GRiM-01/Robotic-Arm/EDPA T Thakurdin 22139454 INDIVIDUAL FINAL REPORT (1).pdf

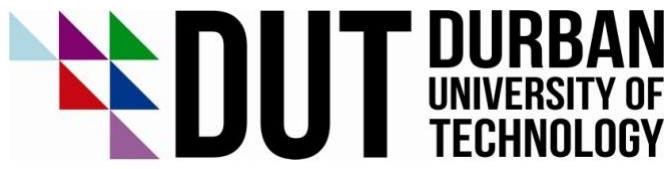
[picture p1: figure]

## Department of Electronic and Computer Engineering

## Electronic Design Project 3A (EDPA301)

## Assessment Number 5A

## Final Report (Individual)

## Project Title: Remote Controlled Robotic Arm that Measures Distance

By

## Group Number: A

Student Surname | Initials | Student Number
Thakurdin | T Y | 22139454

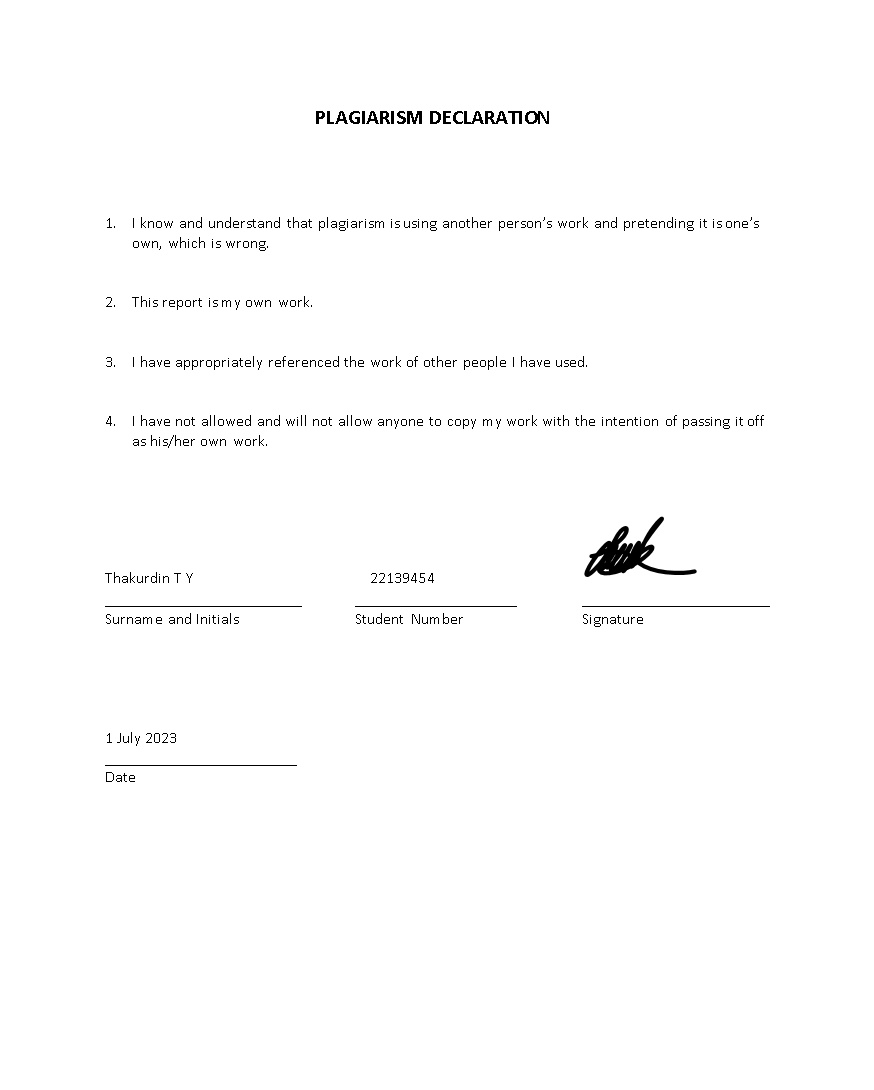
[picture p2: page 2]

ii

iii

### Abstract

This report discusses the design, construction, and testing of the remote-controlled robotic arm that

can measure distance project, specifically the joystick and servo motor subsystem.

The remote-controlled robotic arm was controlled by two joystick modules which were used to actuate

three servo motors which in turn enabled the movement of the robotic arm. The system incorporates

two ultrasonic distance sensors for vertical and horizontal distance measurements as well as two

nRF24L01+ modules to facilitate bi-directional wireless communication between the control centre

and the robotic arm microcontrollers. The final distance measurements were displayed on an I2C LCD

screen at the control centre. Indicator LEDs provided visual feedback for button presses and successful

data transfers.

Thus, this project offers a user-friendly and efficient solution for controlling and monitoring the robotic

arm’s functionalities by combining the joystick control of servo motors, ultrasonic sensors for distance

measurement, radio frequency modules for wireless communication, and an LCD screen and indicator

LEDs for real time process monitoring.

iv

### Table of Contents

PLAGIARISM DECLARATION | Error! Bookmark not defined.

v

vi

vii

### List of Figures

viii

### List of Tables

ix

### Table of Abbreviations

Abbreviations | Meaning
LED | Light Emitting Diode
LCD | Liquid Crystal Display
I2C | Inter-Integrated Circuit
Hz | Hertz
GND | Ground
VCC | Voltage Common Collector
RF | Radio Frequency
PS2 | PlayStation 2
DOF | Degrees of Freedom
I/O | Input and Output
ADC | Analogue to Digital Converter
DC | Direct Current

### Chapter 1: INTRODUCTION

### 1.1 Project Overview

A robotic arm is a machine that mimics the movement and motions of a human arm via the use of

linkages and joints which in turn enable the arm to manoeuvre within its defined degrees of freedom

and execute designated tasks [1-3].

Robotic arms are extensively used in medical surgeries, manufacturing, warehouses, assembly lines,

research laboratories and space exploration [4, 5]. They excel in challenging environments, offering

increased precision, repeatability, and efficiency.

In certain scenarios, remote control becomes necessary for robotic arms, particularly in military

applications like remote bomb defusal. This project aimed to undertake the research, design, and

construction of a remote-controlled robotic arm equipped with distance measurement capabilities

which holds potential real-world applications, such as assisting surgeons in intricate procedures where

precision cutting on a minute scale was required [4, 5].

This project utilized joysticks to control the precise actuation of servo motors to facilitate various

horizontal and vertical movements of the robotic arm and once held in a new position, distance

measurement commenced, and the results were displayed on an LCD.

The robotic arm consisted of interconnected joints, specifically the base, shoulder, and elbow joints,

each equipped with their individual servo motors used to facilitate the movement of the robotic arm.

User control was achieved at the control centre by utilizing two dual-axes joystick modules, the

physical X axis and Y axis movements of the joysticks served as analogue inputs for the control centre

microcontroller. This positional data was sent to the robotic arm system where they were converted

into PWM signals. These signals were used to control the rotation of the servo motors, enabling the

operator to manipulate the arm's movement and position.

To measure distance, ultrasonic sensors were implemented. These sensors emit sound waves, and the

distances were calculated based on the time it takes for sound waves to return.

For visual feedback, an LCD screen with an I2C interface was integrated into the system. The control

centre microcontroller was connected to the LCD display. The microcontroller received the transmitted

distance measurement data from the robotic arm system and displayed the final values on the LCD.

The two systems operated on separate DC power supplies which powered the microcontrollers which

in turn powered and controlled their respective components. This enables operators to remotely

control the robotic arm's movements using the joysticks while receiving real-time distance

measurement information on the LCD.

### 1.2 Aims, Objectives and Specifications

### 1.2.1 Aim

The aim of the project was to design, construct and test a remote-controlled robotic arm that was

capable of measuring distance. The project involved the development of two separate systems,

namely the control centre and robotic arm, each equipped with their own dedicated external DC

power supply.

### 1.2.2 Objectives

- Design and develop the control centre and robotic arm systems.
- Implement wireless communication between the control centre and the robotic arm using two

nRF24L01+ transceiver modules.

- Integrate an LCD into the control centre to display distance measurements from the robotic arm.
- Incorporate two PS2 joystick modules as the primary input devices for the control centre.
- Configure the robotic arm system to actuate three servo motors based on the input commands

received from the control centre.

- Utilize the Arduino microcontrollers to control and coordinate the functionalities of the control

centre and the robotic arm system.

- Establish bidirectional communication between the control centre and the robotic arm system to

enable the control centre to receive input commands from the joystick module and transmit them

wirelessly to the robotic arm system to actuate servo motors and transmit the calculated distance

measurements back to the control centre.

- Collaborate effectively with other group members to ensure a cohesive and coordinated project

outcome.

### 1.2.3 Hardware and Performance Specifications

- Arduino Uno Rev 3 microcontroller: The Arduino Uno Rev 3 microcontroller was used to control

the operations and functions of the control centre.

- Arduino ATmega328P microcontroller: The Arduino ATmega328P microcontroller was used to

control the operations and functions of the robotic arm system.

- Servo Motors: The project utilized three servo motors as the main output devices for controlling

the movements of the robotic arm.

- PS2 Dual-Axes joysticks: The joysticks served as the primary input devices for the control centre

and were used to control the movement of the robotic arm.

- I2C LCD: The final distance measurements were displayed at the control centre using the I2C LCD.
- NRF24L01+ transceiver modules: The NRF24L01+ transceiver modules facilitated wireless

communication between the control centre and the robotic arm.

- Accuracy: The robotic arm's movement and distance measurements must be accurate based on

the operator’s control.

- Responsiveness: The project must exhibit minimal delay and provide real-time response to

operator inputs.

- Reliability: The wireless communication between the control centre and the robotic arm must

maintain a consistent connection without significant signal loss.

- Reporting and Documentation: The project must be documented using IEEE referencing and

include technical specifications, wiring diagrams, code documentation, and project management

details.

### 1.2.4 Background and Significance

A robotic arm imitates human arm movements using linkages and joints. It operates within specific

degrees of freedom and performs various tasks in medical surgeries, manufacturing plants,

warehouses, assembly lines, research laboratories and space exploration [4, 5]. They are used in

challenging environments, offering precision, repeatability, and efficiency that a human could not.

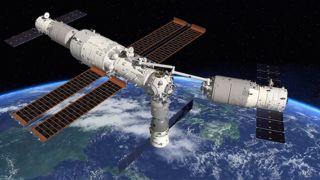
[picture p3: figure]

Figure 1.1 Robotic arm used to position a satellite [5].

A remote-controlled robotic arm with distance measurement capabilities offers valuable technical

benefits in various industries. It enhances operational safety by enabling operators to control the arm from a secure distance, ensuring precise object detection. Furthermore, the integration of the distance

measurement functionality ensures accurate and controlled movements, crucial for tasks that demand

precision [6].

By minimizing manual intervention, the remote-control feature streamlines operations, translating to

improved efficiency and safety [6]. Additionally, the arm's remote accessibility allows for exploration

and maintenance in challenging or remote environments.

### 1.2.5 Project Benefits

- Precise control over the movement and positioning of the robotic arm.
- Accurate distance measurement in two dimensions.
- Real time visual feedback of process operations due to indicator LEDs and LCD.
- Increased safety by performing tasks deemed too dangerous for humans.
- Increase efficiency due to

### 1.2.6 Project Limitations

- The servo motors have a limited rangeability between 0° - 180°.
- The robotic arm’s movement was limited to three DOF.
- The joysticks will degrade overtime and cause inaccuracies.
- The ultrasonic sensors have a limited measurement range from 2 – 19 cm.
- The transceiver module has a transmission rate limit of 250 Kbps to 2Mbps.
- The project faces power constraints due to the microcontrollers’ voltage limits.

### Chapter 2: DESIGN

### 2.1 Project Block Diagram

Figure 2.1 illustrates the systems block diagram. There are two main systems with three distinctstages.

The control centre system and robotic arm system each have an input stage, a process stage, and an

output stage.

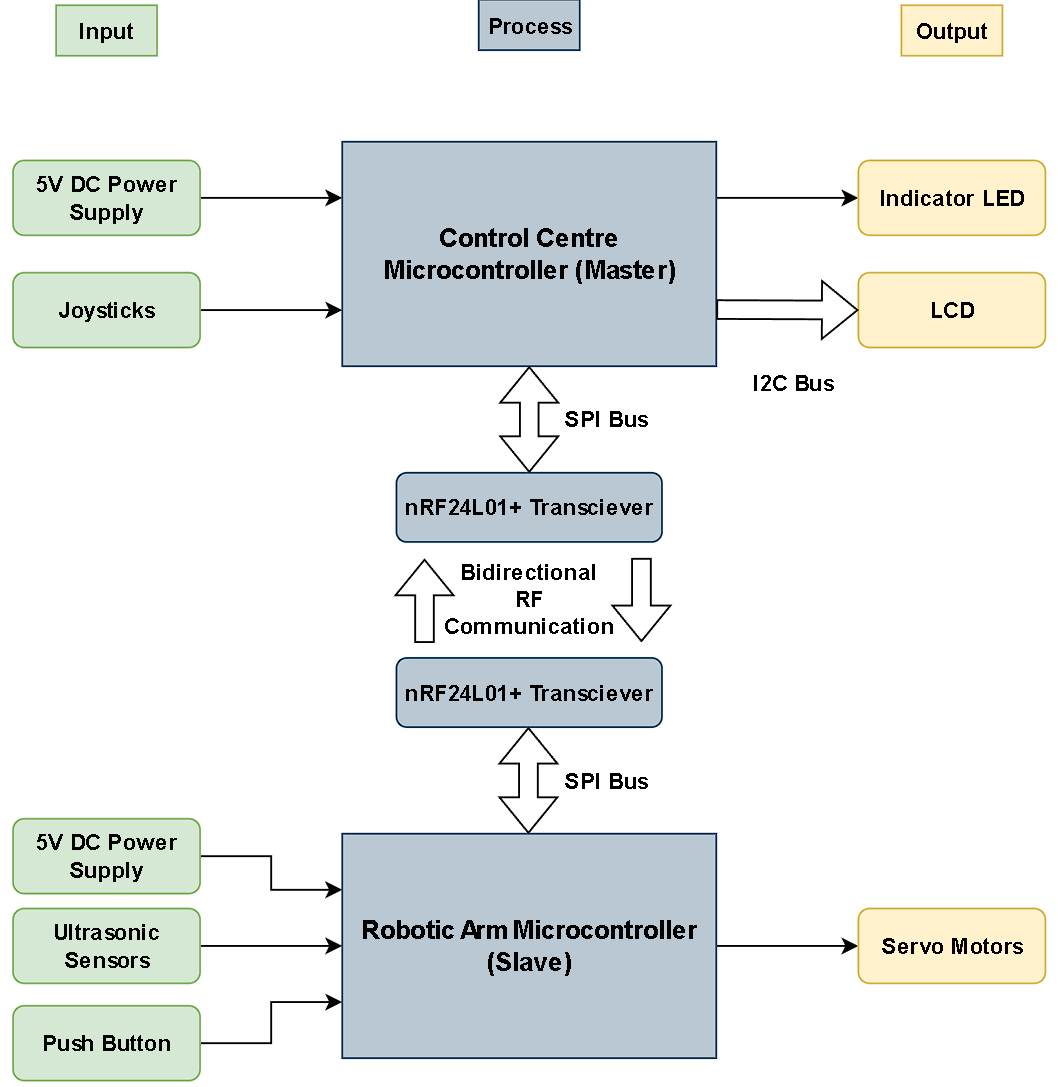
[picture p4: figure]

Figure 2. 1 Project Flowchart

### 2.1.1 Input Stage

With respect to the control centre’s input stage, the microcontroller was powered by a 5V DC power

source, which it used to distribute power to the other control centre components. Furthermore, the

microcontroller read the changing X-axis and Y-axis positions of the joystick as analogue inputs.

Within the input stage of the robotic arm system, the microcontroller was powered by a 5V DC power

source, which it used to distribute power to the other robotic arm system components. Such as the

ultrasonic sensors which functioned as the main input devices of this system furthermore, when the

push button was pressed once, the vertical distance was measured however if the button was pressed

twice, the horizontal distance was measured.

### 2.1.2 Process Stage

Within the process stage, the input data was converted and transmitted or received between the two

microcontrollers. The transmission of data was bidirectional and was facilitated using two nRF24L01+

transceiver modules.

The control centre stored the current position of the joystick and transmitted it to the robotic arm

microcontroller where it was then mapped to an angle between 0° and 180°. This angle was then used

to generate a PWM signal.

The robotic arm microcontroller converted the input from ultrasonic sensors into distance

measurements, in centimetres, which were transmitted to the control centre microcontroller.

### 2.1.3 Output Stage

The robotic arm microcontroller used the previously generated PWM signals to control the actuation

of the servo motors, in addition to this, the rotation of the servo motors caused the movement of the

robotic arm. By changing the position of the arm, various distance measurements could be taken.

The control centre microcontroller used the data which it received from the robotic arm system to

display the final distance measurement on the I2C LCD.

### 2.2 Project Circuit Diagram

As previously discussed, the project consists of two systems that communicate wirelessly., namely the

control centre system and robotic arm system which are shown in figures 2.2 and 2.3.

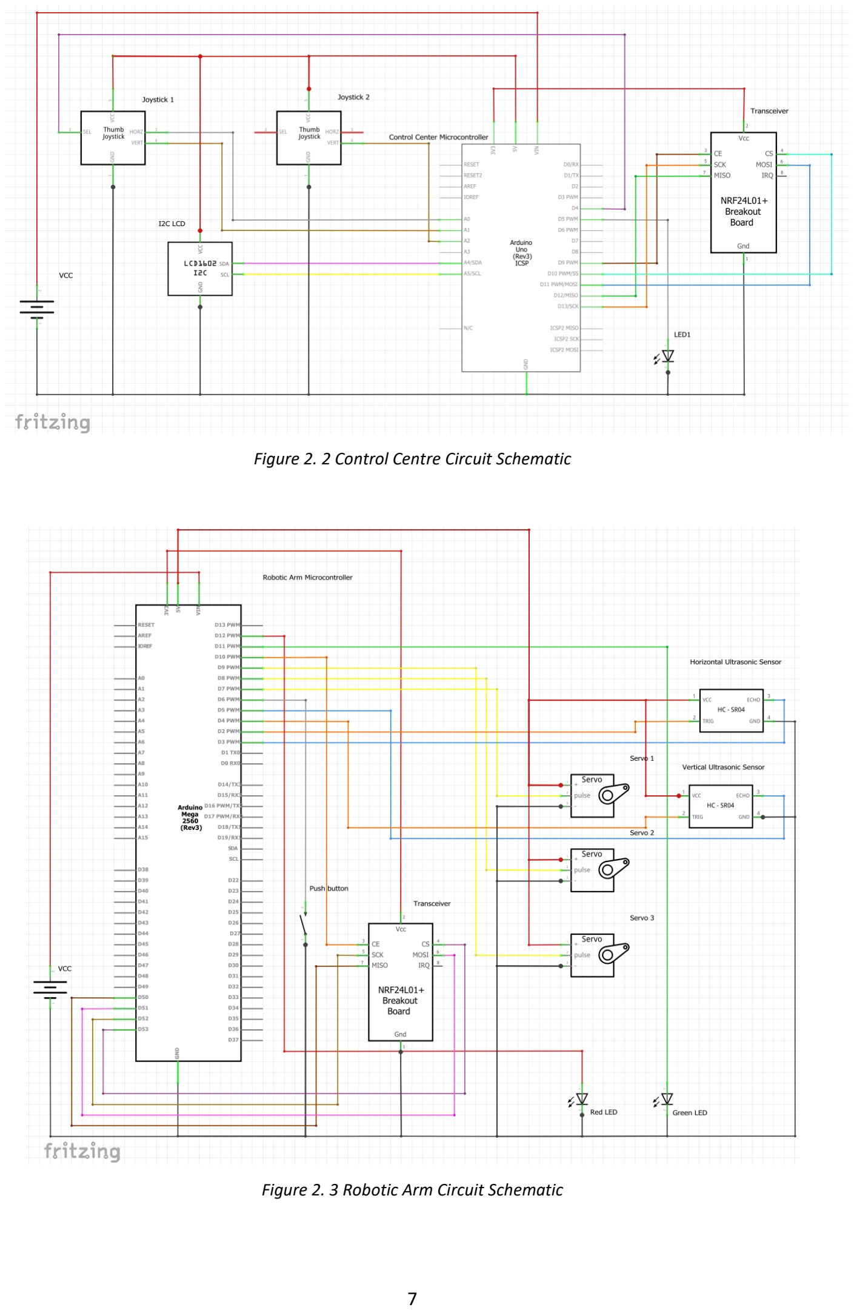
[picture p5: page 16]

Figure 2. 2 Control Centre Circuit Schematic

Figure 2. 3 Robotic Arm Circuit Schematic

### 2.2.1 Movement Stage:

The control centre system as the name suggests was where the operator remotely controlled the

project. This system contained the two dual axis joysticks which functioned as the main input devices

of the control centre that the operator interacted with to control the movement of the robotic arm.

This was accomplished by reading the changing X-axis and Y-axis positions of the joysticks as analogue

inputs. The joysticks were analogue inputs due to their ability to provide a continuous range of values,

which allowed for smooth and precise control over the arm’s movements, which was not achievable

with discrete on/off digital inputs [7, 8].

The joysticks’ positional data underwent serialization, where it was structured and formatted into a

data packet which was wirelessly transmitted to the robotic arm microcontroller using the radio

frequency transceiver modules.

The robotic arm microcontroller received the data packet and extracted the joystick positions. It then

mapped the positional data to an angle between 0° and 180° to make use of the servo motors’ full

range of motion. The mapped angle was used as an argument for the servo.write() function to

internally generate a PWM signal with the desired duty cycle and pulse width.

The PWM signal was generated on the digital I/O PWM pin connected to the signal wire of the servo

motor. The servo motor interpreted the pulse width of the signal, using its built-in control circuit, to

determine the desired degree of rotation, it then adjusted its shaft position based on the received

pulse width, aligning itself to the specified angle [9, 10]. The three servo motors, the base, shoulder,

and elbow servo motors were mounted on the robotic arm. The base servo motor facilitated horizontal

movement while the shoulder and elbow servo motors were responsible for vertical movement.

### 2.2.2 Distance measurements and display stage

To measure the distance covered by the robotic arm, the project included two HC-SR04 ultrasonic

sensors. These sensors emitted sound waves that travelled through the air and reflected off obstacles

encountered along the path.

For vertical distance measurement, the ground surface was detected as an obstacle, while a solid box

served as an obstacle for horizontal distance measurement. By calculating the time duration of the

echo pin's high state and utilizing the speed of sound, the distance could be accurately By using

formula 2-1 where D is the distance measured in cm, t is the time duration of the echo pin's high state,

0.34 is a constant representing the speed ofsound in air which is 0.034cm/µs and the division constant

2 represent the path of the sound wave being emitted to an obstacle its path back.

### D(cm) =

t∗0.34
2

[2-1]

This distance measurement was transmitted to the control centre microcontroller where it was

displayed on a 16×2 LCD which was interfaced with the control centre microcontroller through the I2C

interface.

### 2.2.3 Wireless communications stage

Two nRF24L01+ transceiver modules facilitated the wireless communications between the control

centre and robotic arms systems using radio frequency signals furthermore, the two systems

communicate bidirectionally.

Prior to the transmission stage, the input data was obtained and converted into a data packet. By

checking if the transmission channel was open, the microcontroller determined whether it should

transmit or receive data. If the transmission channel was available, the microcontroller transmitted

the data packet to the other system. Similarly, if the transmission channel was not available, the

microcontroller received the transmitted data packet and extracted the data from the other system.

This process was identical for both the systems. Should neither system have transmitted nor received

data, this would have indicated that either one or both systems were inoperative.

### 2.3 Factors Influencing Component Selection

### 2.3.1 Servo Motors

Precise positional control: Servo motors have built-in feedback mechanisms and control circuits

enabling accurate control of the motor's position. This precision is crucial for robotic arms, which

require precise and repeatable movements.

Compact size: Servo motors are available in compact sizes, making them suitable for robotic arm

designs where space is limited. They were easily integrated into the arm structure without adding

excessive bulk.

Ease of use and compatibility: Servo motors are easy to use and interface with and control due to the

Arduino h.Servo library which simplified their integration and programming.

Cost-effectiveness: Servo motors provided a good balance between performance and cost. They are

more affordable than other high-performance motor options, such as stepper motors or linear

actuators, while still offering the necessary capabilities for robotic arm applications.

### 2.3.2 Joysticks

Intuitive and ergonomic control: joysticks are designed with ergonomics in mind, providing a

comfortable grip and intuitive hand placement. This ensures that users can control the robotic arm

with ease and minimal fatigue over extended periods.

Two-dimensional control: Dual-axis joysticks provide control in two dimensions. This enabled precise

control over the horizontal and vertical movement of the robotic arm.

Simultaneous control: Dual-axis joysticks allow for simultaneous control of both axes.

Compact and lightweight: Dual-axis joysticks are compact and lightweight allowing them to be easily

integrated into the handheld control centre device.

Analogue input: Joysticks were used to provide a continuous range of values, which allowed for smooth

and precise control over movements, which is not achievable with discrete inputs such as a keypad.

Real-time control: Dual-axis joysticks provided real-time control, allowing users to make immediate

adjustments to the arm's position and movement.

### 2.3.3 Ultrasonic Sensors

Non-contact sensing: Ultrasonic sensors operate on a non-contact principle, meaning they do not

require physical contact with objects to measure distance. This feature was advantageous for the

robotic arm as it allows for safe and efficient object detection without the risk of collision or damage.

Fast response time: Ultrasonic sensors provide fast response times due to operating at the speed of

sound.

Cost-effective: Ultrasonic sensors are cost-effective compared to other sensing technologies like lidar

and vision systems. It offered a good balance between performance and cost.

### 2.3.4 nRF24L01+ Transceivers

Wireless communication: The transceivers provide wireless communication capabilities through radio

frequencies; wireless communications was one of the objectives of this project.

Reliable and robust connectivity: The transceivers offered dependable and connectivity, ensuring

stable and consistent communication between the robotic arm and control system.

Low power consumption: The transceivers are designed with low power consumption in mind. The

low power consumption of the transceivers helps prolong the battery life of the robotic arm.

Long-range communication: The transceivers can provide long-range communication capabilities,

allowing robotic arms to be controlled or monitored from a considerable distance.

Cost-effective: The transceivers provide a cost-effective solution for wireless communication and

offered a good balance between performance and cost.

### 2.3.5 I2C LCD

Simplified wiring: I2C LCD modules utilize the I2C protocol for communication. Compared to traditional

parallel LCDs, I2C LCD modules require fewer wires for connection.

Cost-effective: I2C LCD modules are cost-effective compared to other display technologies, such as

graphical LCDs or OLED displays. It provided a good balance between functionality and cost.

### 2.4 Software Design Method:

The following paragraphs explain the method and process of designing and implementing the code

and algorithms used for this project.

### 2.4.1 Requirements Analysis

The basic functionality and capabilities of the project were determined such as the range of motion,

number of degrees of freedom, and specific tasks the project had to perform such as distance

measurement and displaying the result.

### 2.4.2 System Architecture

The major components of the project were identified, such as the servo motors, joysticks, ultrasonic

sensors, transceiver modules and LCD. Flowcharts were then developed to visualize how these

components would work together to achieve the desired movements and functionality.

### 2.4.3 Algorithm Design

Algorithms for each subsystem were developed such as the joystick and servo motor control algorithm.

### 2.4.4 Code Organization

The individual algorithms were combined and organized into logical sections based on the different

components and systems to simplify troubleshooting and subsystem integration.

### 2.4.5 Component and sensor Integration

The final project was constructed, and the code was uploaded to assess if the project functioned and

met the specified objectives.

### 2.4.6 Testing and Iteration

The project was evaluated to ensure that the arm moved correctly and performed the desired tasks.

The code was enhanced through an iterative method to refine and functionality and address issues.

### 2.5 Software Resources

### 2.5.1 Fritzing

The Fritzing software was used to design and draw out the circuit diagrams.

### 2.5.2 Arduino IDE

This software was used to develop, run, and upload the code to the microcontrollers to translate the

change in position of the joystick into the actuation of the servo motors.

### 2.5.3 Diagrams.net

This software was utilized to design the system block diagram and flowchart for the servo motor and

joystick subsystem.

### 2.5.4 Tinkercad

This software was used to evaluate and visualize the range of motion of the servo motors through a

sweeping program.

### Chapter 3: CONSTRUCTION

### 3.1 Preliminary information on joystick and servo motor construction

The joysticks and servo motors were included in the 4DOF robotic arm kit and were interfaced with

their respective microcontrollers according to the circuit diagrams and the wiring configurations tables

3.2 and 3.3.

### 3.1.1 Joystick Specifications

The following are the joystick specifications from the manufacturer [7]:

- Dual-Axis, X and Y axis.
- Dimensions: 4 X 2.6 X 3.2cm.
- Two potentiometers for two axes.
- Connector Pins: +5Vcc, GND, VRx, VRy, SW.

The joysticks position was based on values between 0 and 1023 for both the X and Y axis, this is clearly

depicted in figure 3.1.

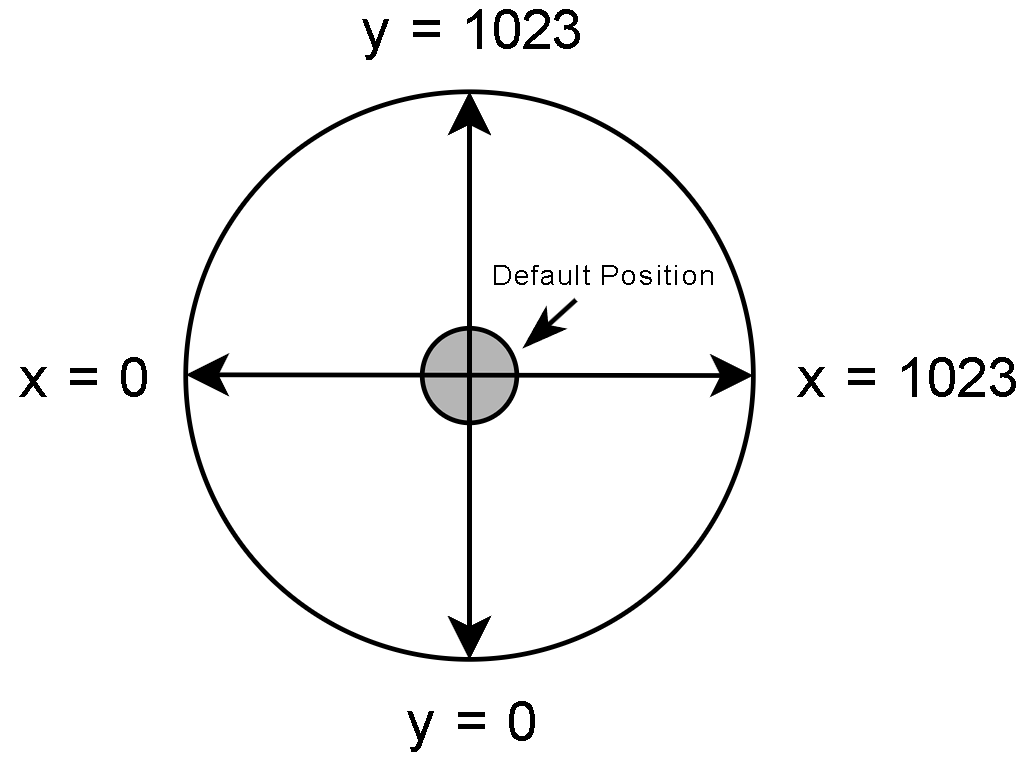
[picture p6: figure]

Figure 3. 1 Joystick Position Detection

The joystick values were represented as numbers from 0 to 1023 because they are measured using the

Arduino Uno’s 10-bit ADC [8]. This means the joystick's position was divided into 1024 steps, starting

from 0. The minimum position was represented by 0, and the maximum position was represented by

1023. These values were used to accurately track the joysticks’ movement.

### 3.1.2 Servo Motor

As shown in figure 3.2, the servomotors consist of a regular DC motor which was controlled by a built-

in control circuit [9]. The servo’s torque and speed are set by the gears and lastly the position

potentiometer provides feedback on the angle of rotation of the servo motor [9, 10].

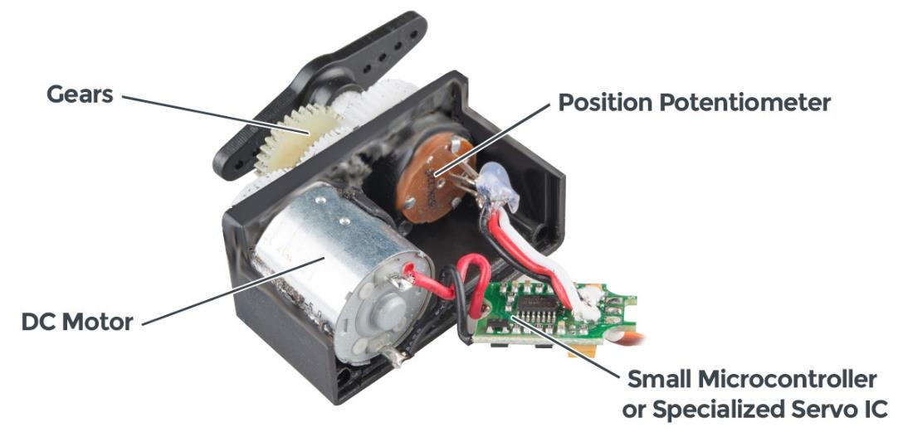
[picture p7: figure]

Figure 3. 2 Servo Motor Deconstructed [9]

The microcontroller maps the position of the joystick to an angle between 0° and 180°. This angle was

then used to generate a PWM signal which dictated the angle of rotation of the servo motor [9, 10].

The following are servo motor specifications from the manufacturer [11]:

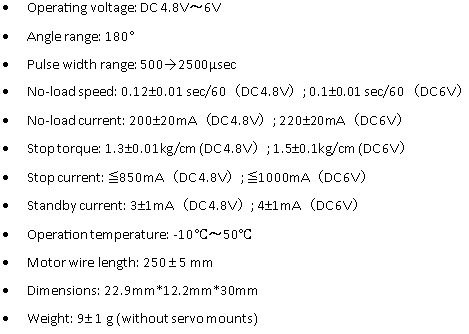
[picture p8: figure]

### 3.2 Individual role and tasks in construction

The role of the electromechanical servo motor engineer for this project required interfacing the servo

motors and joysticks with their respective microcontrollers as well, adjusting the screw tensions to

ensure the robotic arm moved smoothly and to ensure that the housings did not disrupt the

movement of the joysticks or servo motors.

Furthermore, a prototype for the joystick and servo motor subsystem was developed where the servo

motors and joysticks were connected to a single microcontroller to assess the functionality and

interactions as show in figure 3.3.

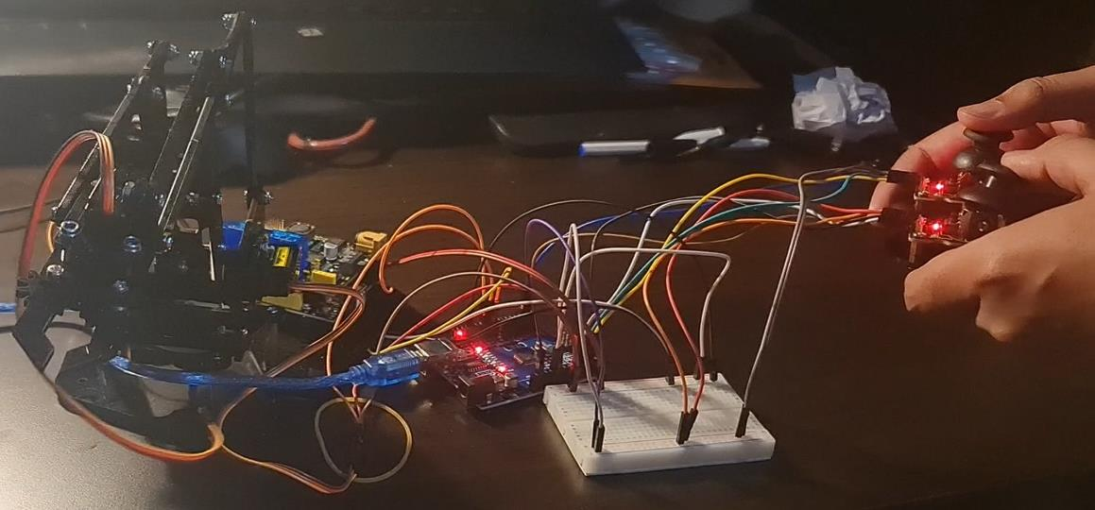
[picture p9: figure]

Figure 3. 3 Constructed Prototype for Servo Motor and Joystick Subsystem

### 3.3 Construction Overview

Preliminary circuit designs for subsystems and prototype were created using the Fritzing software.

Group members constructed subsystems according to their designated rolesto ensure proper working

of the components, demonstrate an understanding of their assigned tasks and limit errors incurred by

the final project artefact.

Following the successful testing of each subsystem, a prototype was constructed by combining the

individual subsystems into either the control centre system or the robotic arm system.

The construction process involved assembling the robotic arm structure according to the manual

provided with the 4DOF Robotic Arm kit as well as interfacing the electronic and mechanical

components together and lastly uploading the codes in annexures C and D which were developed

using the flowcharts in annexures E and F.

Furthermore, the servo motors were mounted onto the robotic arm structure and functioned asjoints.

The base servo motor rotated the base of the robotic arm allowing for horizontal movement while the

shoulder and elbow servo motors raised and lowered the arm’s linkages allowing for vertical

movement.

The vertical distance measuring ultrasonic sensor was mounted on the robotic arm structure in place

of the claw, while the horizontal distance measuring sensor was mounted at the base on the robotic

arm.

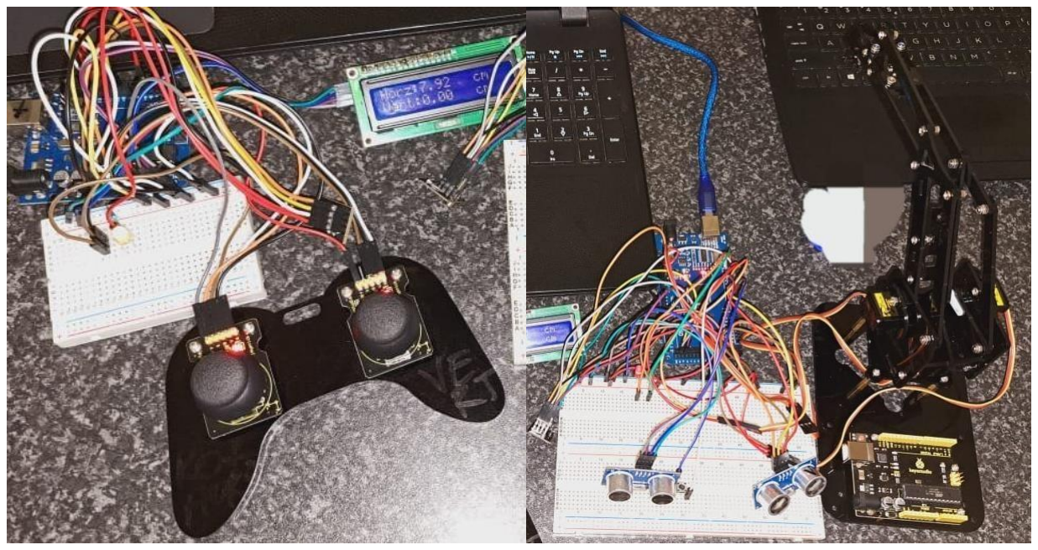
[picture p10: figure]

Figure 3. 4 Constructed Prototype for Control Centre and Robotic Arm

The project was assembled according to the designed circuit schematics and the wiring configurations

in tables 3.1 to 3.3.

Table 3. 1 Transceiver Module Pinout

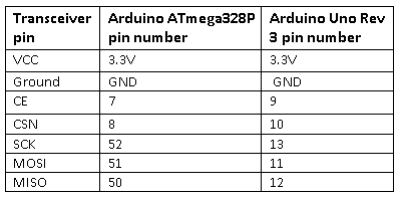
[picture p11: figure]
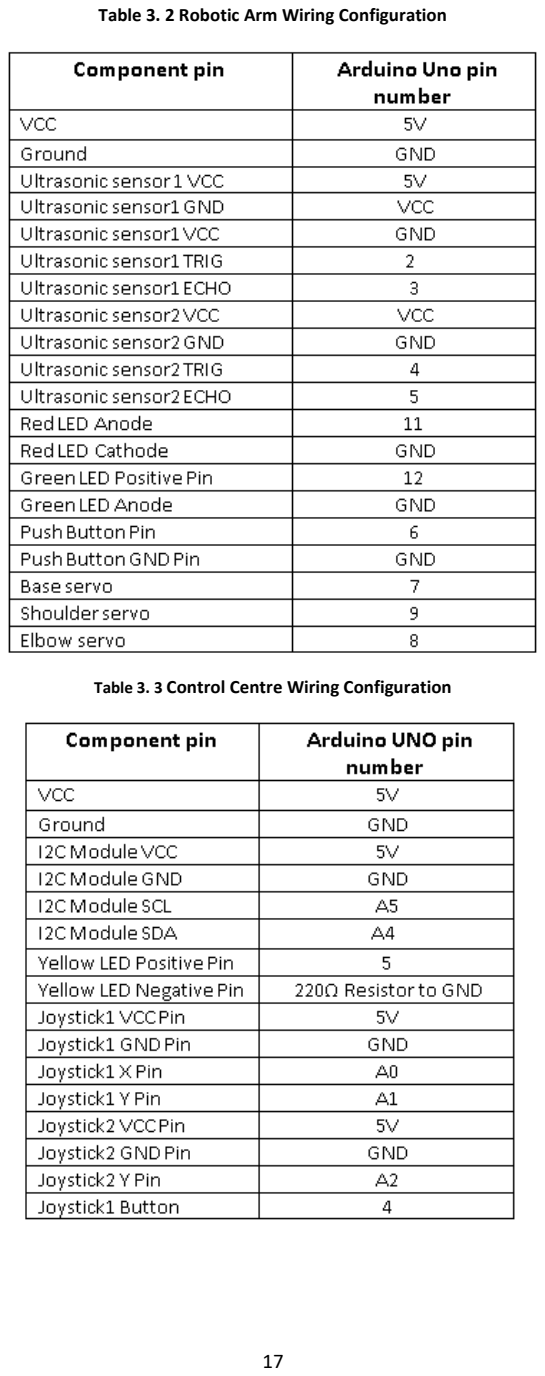
[picture p12: page 26]

Table 3. 2 Robotic Arm Wiring Configuration

Table 3. 3 Control Centre Wiring Configuration

Lastly, housing for both the robotic arm and control centre system were constructed to provide a layer

of protection to the components. Lastly through an iterative method, the prototype was refined into

the final artefact as can be seen in figure 3.5.

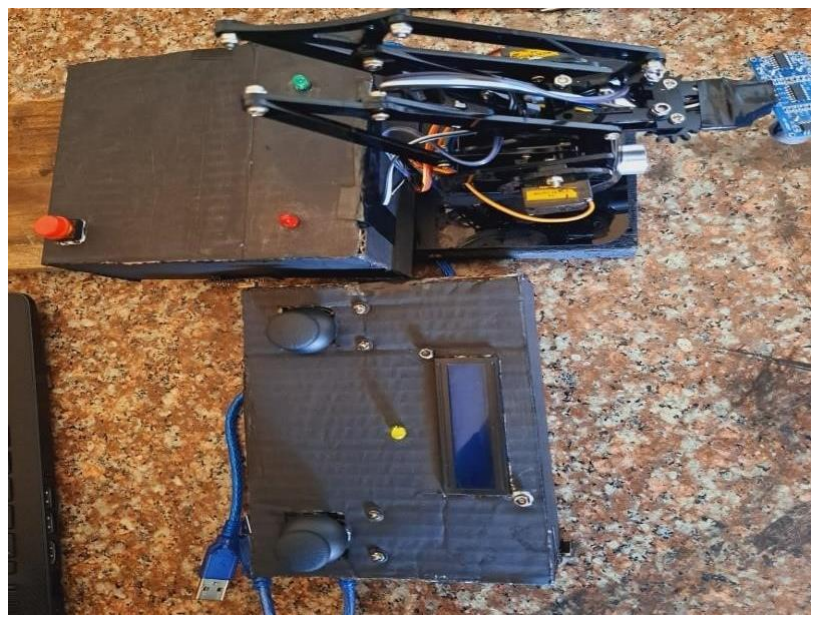
[picture p13: figure]

Figure 3. 5 Constructed Final Prototype for Control Centre and Robotic Arm

### Chapter 4: TESTING

### 4.1 Servo Motor Range of Motion Testing

The code used in annexure A was used to assess the full range of motion of the servo motors using a

sweep function that would increment and change the angle of the servo motor incrementally.

Subsequently, the serial monitor and plotter in figure 4.1 depict the results of this test. As can be seen,

the servo motor rotated from 0° to 180° and then from 180° to 0° repeatedly.

The sawtooth waveform occurs due to the delay where the servo motor stops for fifteen microseconds

and then flips the direction it rotates in, the serial plotter registered this as the servo motor starting at

180° again.

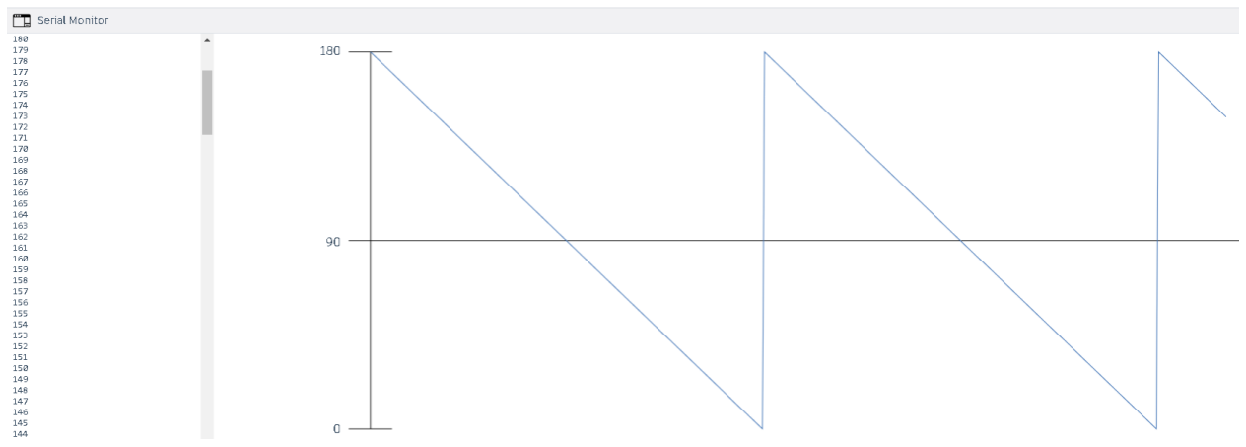
[picture p14: figure]

Figure 4. 1 Serial Monitor and Plotter for Servo Sweep Code

Furthermore, the codes in annexure I and J were used to calibrate the servo motors minimum and

maximum angles.

### 4.2 Subsystem Movement testing

An initial prototype circuit was constructed as shown in figures 4.2 and 4.3. The circuit consisted of the

robotic arm, servo motors, joysticks, and a single microcontroller. This test circuit was built to isolate

the servo motors and joysticks from the other subsystems within this project. This was done to

evaluate the aforementioned components and ensure that this subsystem was operational to lower

the risk of causing or incurring errors when the final project was constructed. Furthermore, each group

member performed a similar task with their respective subsystems where applicable.

Annexures G and K depict the subsystem flowchart and code, respectively. The code functions by

reading the changing position of the joystick as an analogue input and converting it to a PWM signal

used to control the rotation of the servo motors. By pressing the left joystick button, the servo motors enter hold mode where the position of the robotic arm does not change regardless of joystick input.

To exit hold mode, the joystick button simply had to be pressed again.

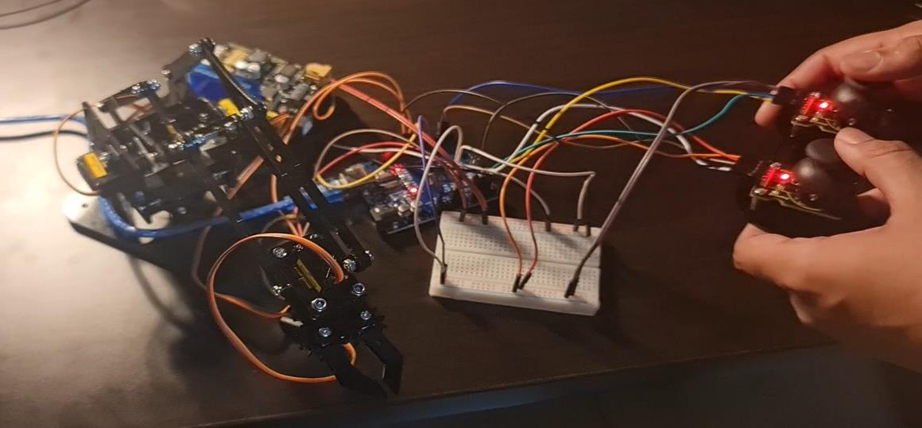
[picture p15: figure]

Figure 4. 2 Servo Motor and Joystick Subsystem Prototype

### 4.3 Project Testing

Once all the subsystems were interfaced the projects control centre and robotic arm systems were

powered on. The joysticks were used to control the movement of the robotic arm. Once the arm was

in the desired position, a push button was pressed once to read the vertical distance measurements

using the ultrasonic sensor 1 and when pushed twice ultrasonic sensor 2 was used to take the

horizontal distance measurements.

For vertical distance measurements, the arm’s vertical position was changed relative to the surface the

robotic arm rested on as this surface was the obstacle that ultrasonic sensor 1 detected. However, for

the horizontal distance measurement, an obstacle was introduced for ultrasonic sensor 2 to measure

the distance. The arm would move into the desired position and the relevant distance measurements

were taken as shown in figures 4.4 and 4.5.

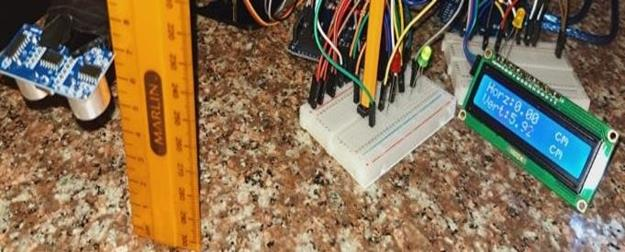
[picture p16: figure]

Figure 4. 3 Vertical Distance Measurement Test

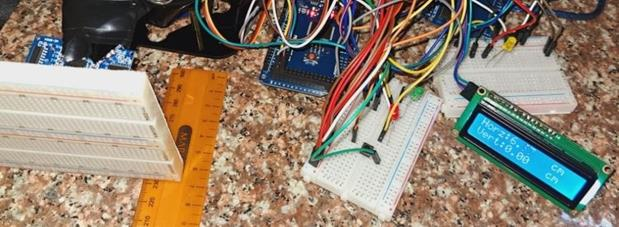
[picture p17: figure]

Figure 4. 4 Horizontal Distance Measurement Test

To verify the systems were functional, the LCD was used to display the distance measurements and

LED indicators depicted when a distance measurement was being done as well as when successful

data transfers had occurred between the control centre and the robotic arm systems.

### Chapter 5: RESULTS

### 5.1 Servo Motor and Joystick results

The servo motors actuated the joysticks precisely and accurately as intended. Figure 5.1 depicts the

serial monitor used to capture the changing position of the joysticks. The X and Y values correspond

to the joystick position as depicted in figure 3.1.

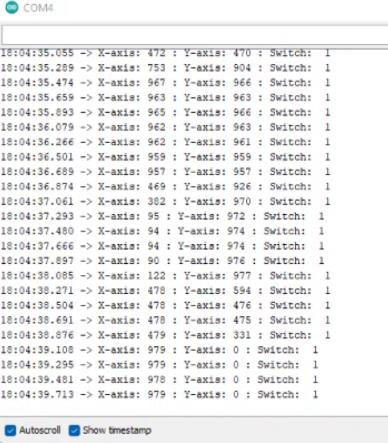
[picture p18: figure]

Figure 5. 1 Joystick Position Results

These values were mapped to an angle between 0° and 180° to actuate the servo motors. This angle

was used to generate a PWM signal to actuate the servo motors to the desired angles. Figure 3.2

depicts the relationship between angle of the servo motor’s rotation and the pulse width of the signal

sent to the servo motor.

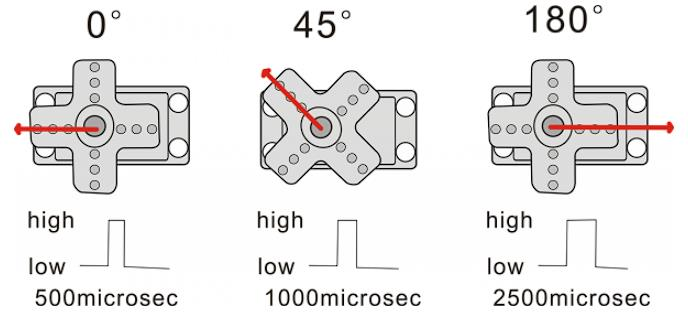
[picture p19: figure]

Figure 5. 2 Relationship Between Pulse Width and Servo Rotation [11]

### 5.2 Project Results

The measurement results obtained were accurate as expected however, there were discrepancies

caused by servo jitter, which are erratic movements of the servo motors caused by their high operating

speeds. Insufficient screw tension also inhibited the desired motion of the robotic arm however once

these issues were addressed, the robotic arm’s movement was smoother and more controlled.

Further discrepancies were caused by the ultrasonic sensor not being perfectly parallel to the

measured object as well as possible electrical noise as well as radio frequency interference from the

transceiver modules.

Table 5.1 shows the largest and the least variations that were measured during the testing phase.

Furthermore, equation 5-1 explains how the percentage error was calculated.

%E =

Ultrasonic Sensor Distance−Ruler Distance Ultrasonic Sensor Distance

× 100% | [5-1]

Table 5. 1 Final Project Distance Measurement Results

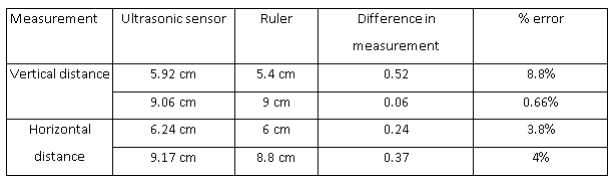
[picture p20: figure]

Figures 5.3 and 5.4 show the testing procedure for horizontal and vertical distance measurement, respectively. The green LED indicates horizontal distance measurement mode while the red LED indicates vertical distance measurement mode.

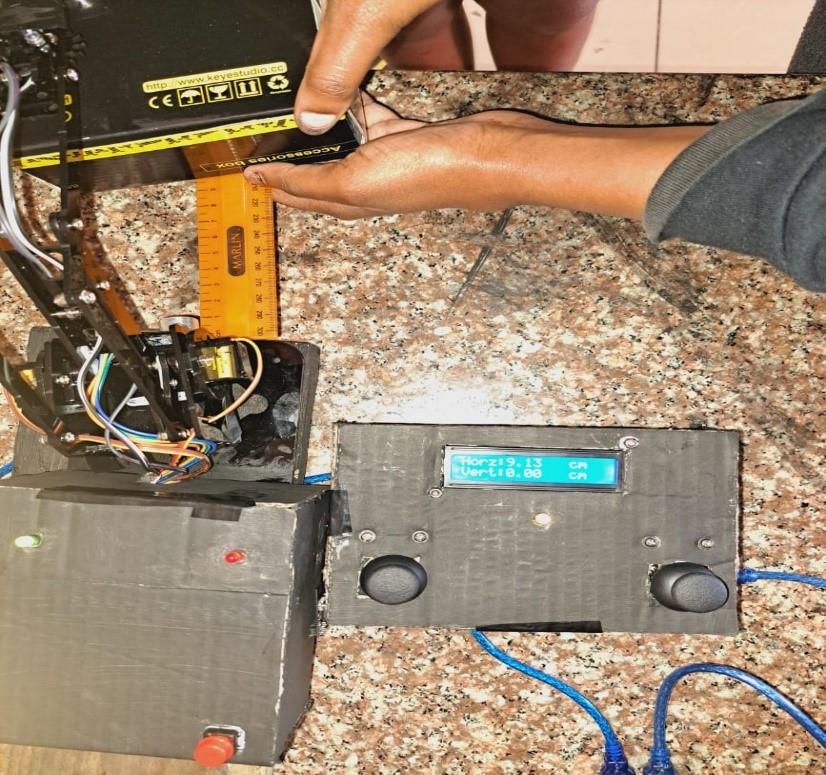
[picture p21: figure]

Figure 5. 3 Final Project Horizontal Distance Measurement

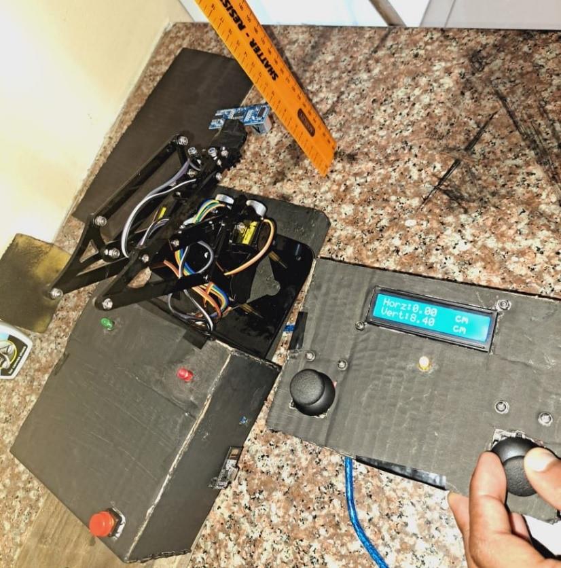
[picture p22: figure]

Figure 5. 4 Final Project Horizontal Distance Measurement

### Chapter 6: PROBLEMS AND SOLUTIONS

Table 6. 1 Problems and Solutions regarding servo motors and joysticks

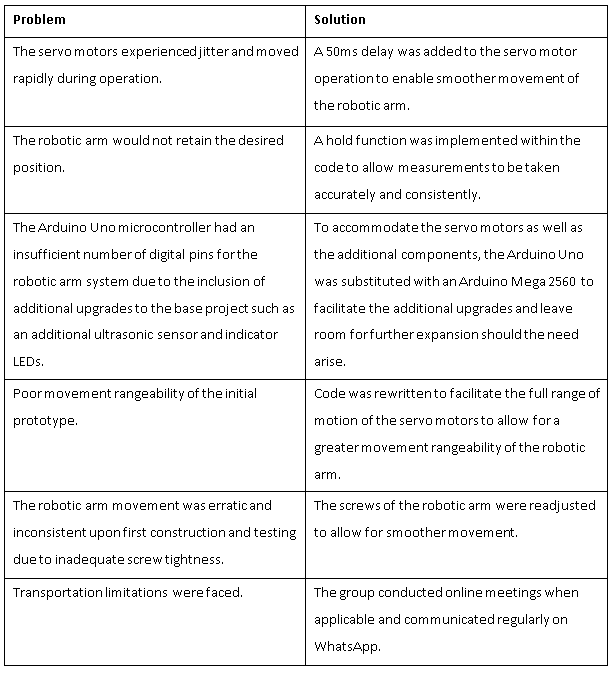
[picture p23: figure]

### Chapter 7: PROJECT MANAGEMENT

### 7.1 Group Schedule

The group schedule is a culmination of all individual and group tasks such as project research,

subsystem development, report writing, prototyping, and presenting.

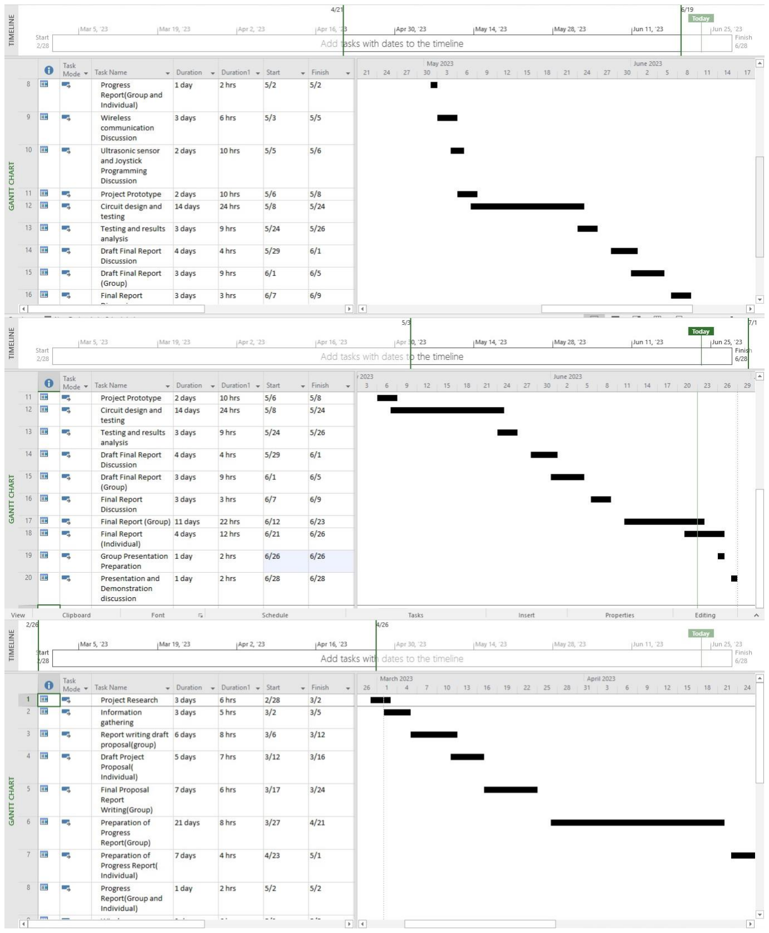
[picture p24: figure]

Figure 7. 1 Group Gantt Chart

Overall, the project deadlines were met in due time due to the time management skills of Group A’s

members. In general, each group member performed their required tasks within their designated time

frame with negligible discrepancies. This allowed the group to functioning smoothly with minimal

disruptions.

### 7.2 Individual Schedule

The individual tasks of the Electro-Mechanical Servo Motor Engineer were distributed between the

two main systems of the project since the servo motors were output devices for the robotic arm

system while the joysticks were input devices for the control centre.

Thus, initialresearch on the inner machinations and implementations of the joysticks and servo motors

were necessary to design circuits and flowcharts as well as to understand in detail the processes and

operations that the servo motors and joysticks would undergo. Following this, Arduino code was

developed to assess and integrate the aforementioned components into their respective systems.

Lastly troubleshooting was performed and errors that were incurred were appropriately dealt with as

discussed in table 6.1.

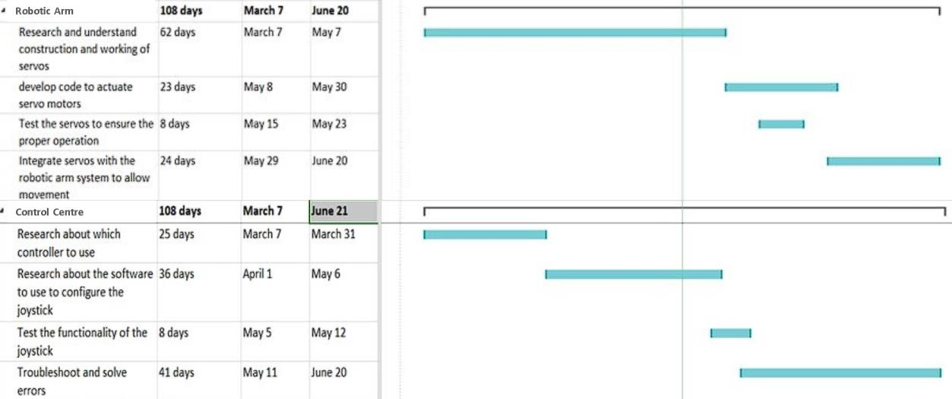
[picture p25: figure]

Figure 7. 2 Individual Role Gantt Chart

### 7.3 Cost and Quantity

The following tables display the proposed costs and additional project costs, respectively. Thus, the

project did expend more capital than intended due to the oversight of the costs of construction of the

housings as well as damaged or insufficient components. However, the additional capital was used to

ensure proper working of the project and to enhance the overall functionalities of the project and

provide expansion possibilities for future iterations of the project should the need arise.

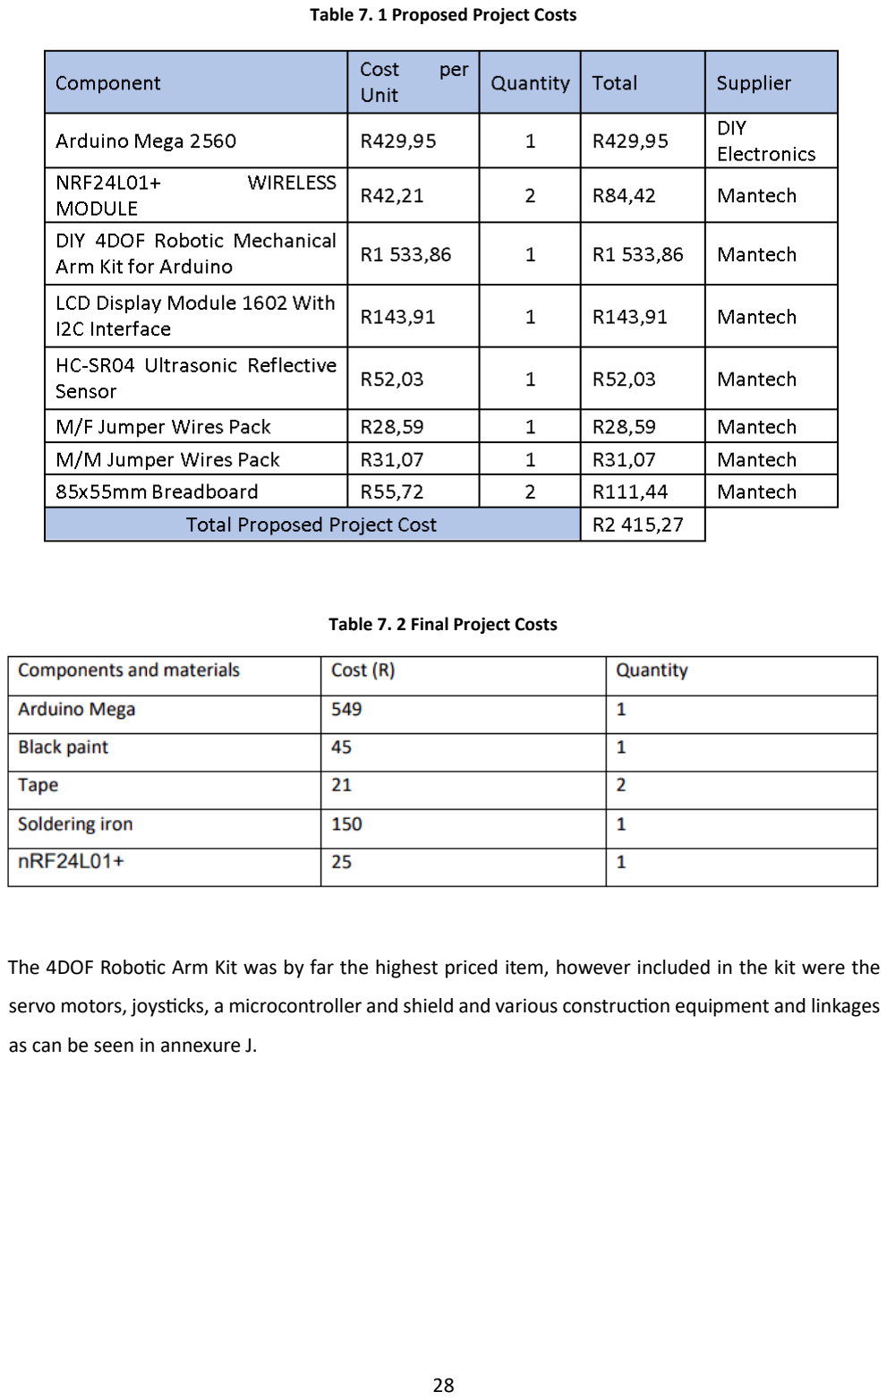
[picture p26: page 37]

Table 7. 1 Proposed Project Costs

Table 7. 2 Final Project Costs

The 4DOF Robotic Arm Kit was by far the highest priced item, however included in the kit were the

servo motors, joysticks, a microcontroller and shield and various construction equipment and linkages

as can be seen in annexure J.

### 7.4 Organogram and roles

### 7.4.1 Group Roles

Each member had a designated task, based on the organogram in figure 7.1, that they were required

to complete in a specific time frame according to the group Gantt chart.

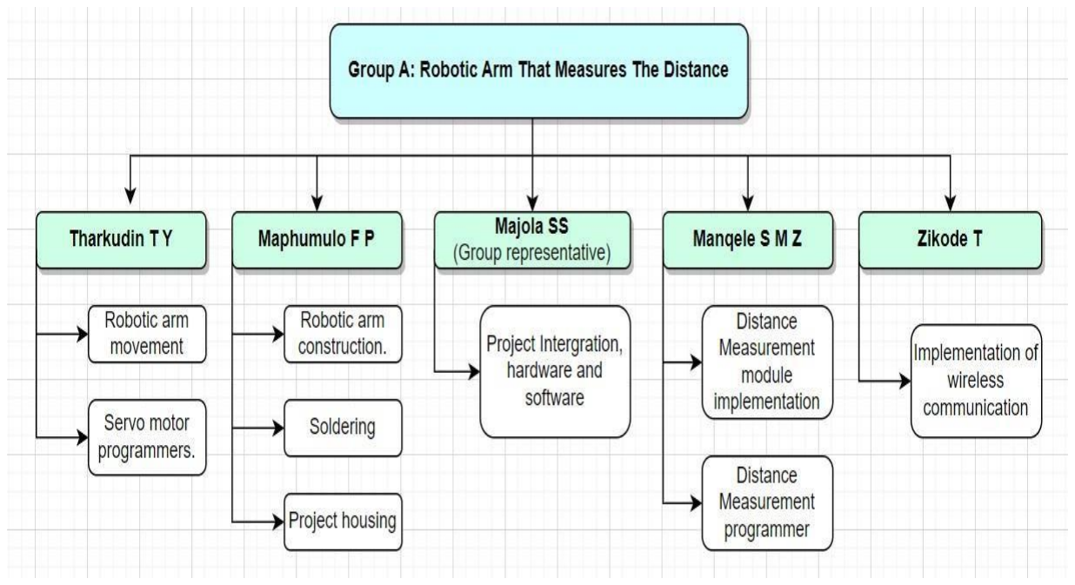
[picture p27: figure]

Figure 7. 3 Group Organogram

Table 7. 3 Group Members and Their Designated Tasks

Group Member | Designated Engineering Tasks
Thakurdin T Y | Electro-Mechanical Servo Motor Engineer and Arduino programmer
Maphumulo F P | Electro-Mechanical Assembly Technician
Maloja S S | Integration Specialist and Arduino Programmer
Manqele S M Z | Ultrasonic Distance Measurement Specialist and Arduino Programmer
Zikode T | Wireless Communication Specialist and Arduino Programmer

### 7.4.2 Individual Role

The role of an Electro-Mechanical Servo Motor Engineer and Arduino programmer within this project was to interface the servo motors and joysticks with their respective systems, develop code to translate the changing X and Y positions of the joystick into the actuation of the servo motors and lastly to troubleshoot errors incurred by this subsystem.

### Chapter 8: CONCLUSION

### 8.1 Overall Conclusion

In conclusion, by harnessing the precision and ergonomics of joysticks as input devices and with the

precise positioning capabilities of servo motors as output devices, operators gain the ability to exert

intuitive and efficient control over the movement and positioning of the robotic arm which allowed

for smooth and accurate motion.

One key advantage of this remote-control system was the enhanced manoeuvrability it offers because

operators can achieve precise movements without worry of being in the path of the arm’s movement.

Moreover, the implementation of the remote-control functionality contributes to improved safety. By

eliminating the need for direct physical contact with the machinery, operators can safely control the

robotic arm in hazardous environments or hard-to-reach locations. This remote operation capability

enhances overall safety by minimizing potential risks associated with an operator being in close

proximity to moving parts.

In summary, the combination of servo motors with joysticks provided a user-friendly, precise, and

reliable solution for the control of the project’s robotic arm. Furthermore, by facilitating the

movement of the robotic arm, the joysticks and servo motors allowed the ultrasonic sensors to take

various distance measurements in numerous positions. Thus, the objectives that were set for this

project were successfully met which resulted in the final project meeting the design requirements and

functioning as intended.

### 8.2 Decisions Made

An additional ultrasonic sensor was integrated into the robotic arm system, allowing accurate distance

measurement in both vertical and horizontal dimensions.

To accommodate the additional components, including the second ultrasonic sensor, the Arduino Uno

was replaced with the Arduino ATmega328P due to its increased digital pin capacity. This enabled

seamless integration of enhancements and potential future expansion.

Indicator LEDs were added to visually indicate data transmission and sensor readings, simplifying

monitoring of operations.

To enhance the overall functionality and aesthetics of the control centre and robotic arm, a housing

was designed and constructed. The housing reduced wire clutter and provided protection to delicate

components as well as presented a neat and organized appearance.

### 8.3 Observations

- The intuitive nature of joysticks as input devices enabled operators to swiftly assimilate to their

functionality, which allowed the operators to quickly grasp how to use them effectively.

- The servo motors operate at high speeds which can cause jitter however a small delay should be

used to counteract this.

- Screw tension of the robotic arm can restrict the motion of the robotic arm if too tight or diminish

control of the movements if too loose.

### 8.4 Outcomes

- The project was successfully completed within the allocated time frame.
- Project aim and objectives were achieved.
- Resources, including time, budget, and labour were used effectively to complete the project.
- Through an iterative method the project’s quality and efficiency was improved.
- Intuitive operator control was achieved.
- Valuable insights on the importance of teamwork and co-operation when solving complex

engineering problems were gained.

### 8.5 Recommendations

Should the robotic arm be required to lift an external load, the claw servo motor should be

implemented. In addition to this, servo motors with a higher torque should be used depending on the

expected operating loads.

Collision prevention should be implemented. The arm should use its sensors to detect obstacles in its

path and the user input from the joysticks should be overridden, following this, the servos should

either avoid the obstacle or stop before contacting it.

The elbow and servo motor should actuate between 0° and 90° to prevent the arm from

unintentionally contacting the ground and damaging the sensors.

### REFERENCES

[1] J. Flynt, “What are robotic arms and how do they work?,” 3D Insider, 2 July 2019. [Online].

Available: https://3dinsider.com/what-are-robotic-arms. [Accessed 25 June 2023].

[2] P. Shepley, “What is a robotic arm?,” EasyTechJunkie, 21 February 2023. [Online]. Available:

https://www.easytechjunkie.com/what-is-a-robotic-arm.htm. [Accessed 25 June 2023].

[3] S. Daley, "Robotics: What Are Robots? Robotics Definition & Uses," Built In, 18 August 2022.

[Online]. Available: https://builtin.com/robotics [Accessed 25 June 2023].

[4] Y. Stolworthy, “Robots Can Make Great Surgical Assistants,” Medical Daily, 2 September 2020.

[Online]. Available: https://www.medicaldaily.com/robotic-surgery-helps-surgeons-perform-

more-precise-surgery-455742. (https://www.medicaldaily.com/robotic-surgery-helps-surgeons-perform-more-precise-surgery-455742) [Accessed 25 June 2023].

[5] A. Jones, “On China's new space station, a robotic arm test paves way for future construction,”
Space.com, 11 January 2022. [Online]. Available : | https://www.space.com/china-

space-station-robotic-arm-construction-test (https://www.space.com/china-space-station-robotic-arm-construction-test) [Accessed 25 June 2023].

[6] M. Stevens, “Pros and cons of using industrial robots in your manufacturing operation,”

WIPFLI, 7 September 2021. [Online]. Available: https://www.wipfli.com/insights/articles/mad-

pros-and-cons-of-using-industrial-robots-in-manufacturing (https://www.wipfli.com/insights/articles/mad-pros-and-cons-of-using-industrial-robots-in-manufacturing) [Accessed 25 June 2023].

[7] | "KY-023 | Dual-axis | Joystick | Module." | Keyestudio | [Online]. | Available:

https://www.mantech.co.za/datasheets/products/KY-023-220909A.pdf [Accessed 29 June

| 2023].
[8] S. R. Karthiga, “How To Connect Arduino Joystick In Arduino Uno,” C# Corner [Online].

https://www.c-sharpcorner.com/article/how-to-connect-arduino-joystick-in-arduino-uno/

[Accessed 29 June 2023].

[9] | “Servos | Explained,” | SparkFun | Electronics | [Online]. | Available:

https://www.sparkfun.com/servos [Accessed 29 June 2023].

[10] P. Evans, “Servo Motor Explained,” The Engineering Mindset, 23 January 2022. [Online].

Available: https://theengineeringmindset.com/servo-motor-xplained/. [Accessed 29 June

| 2023].
[11] | “KS0194 | Micro | Servo.” | Keyestudio | [Online]. | Available:

https://wiki.keyestudio.com/Ks0194_keyestudio_Micro_Servo [Accessed 29 June 2023].

### ANNEXURES

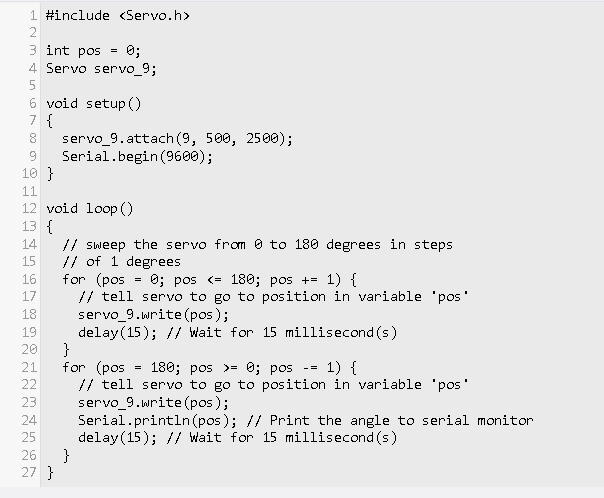
[picture p28: figure]

Annexure A: Servo motor sweep code for range of motion evaluation

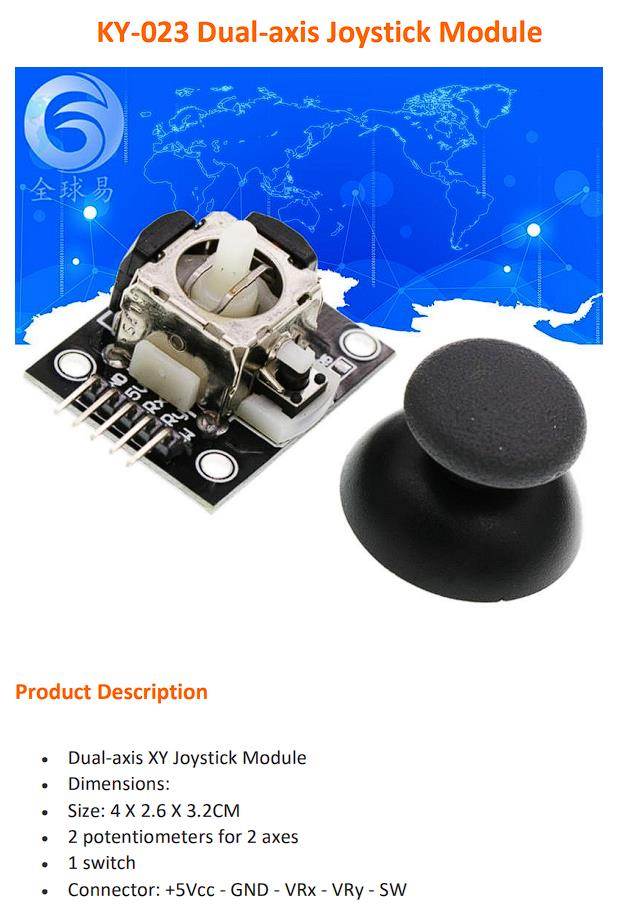
[picture p29: figure]

Annexure B: Joystick Datasheet

Annexure C: Robotic Arm code

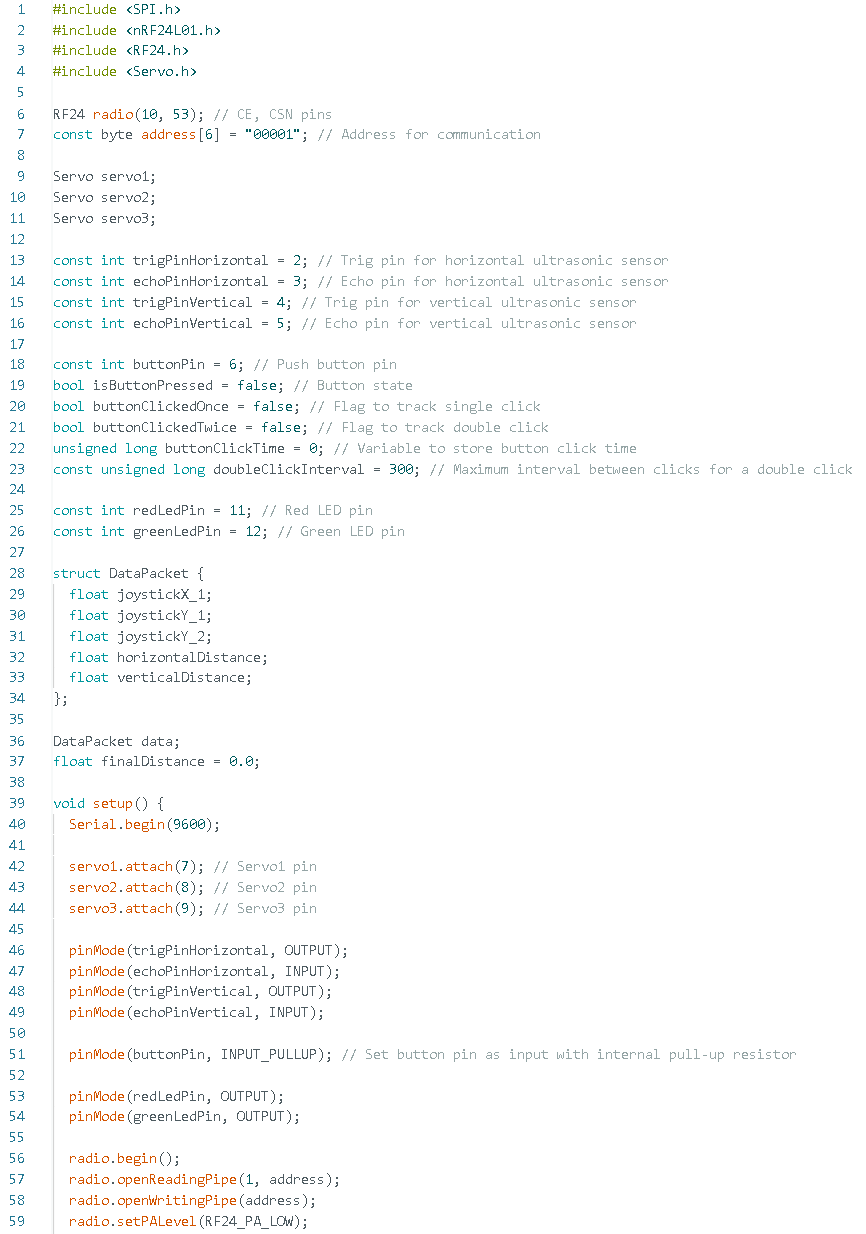
[picture p30: figure]

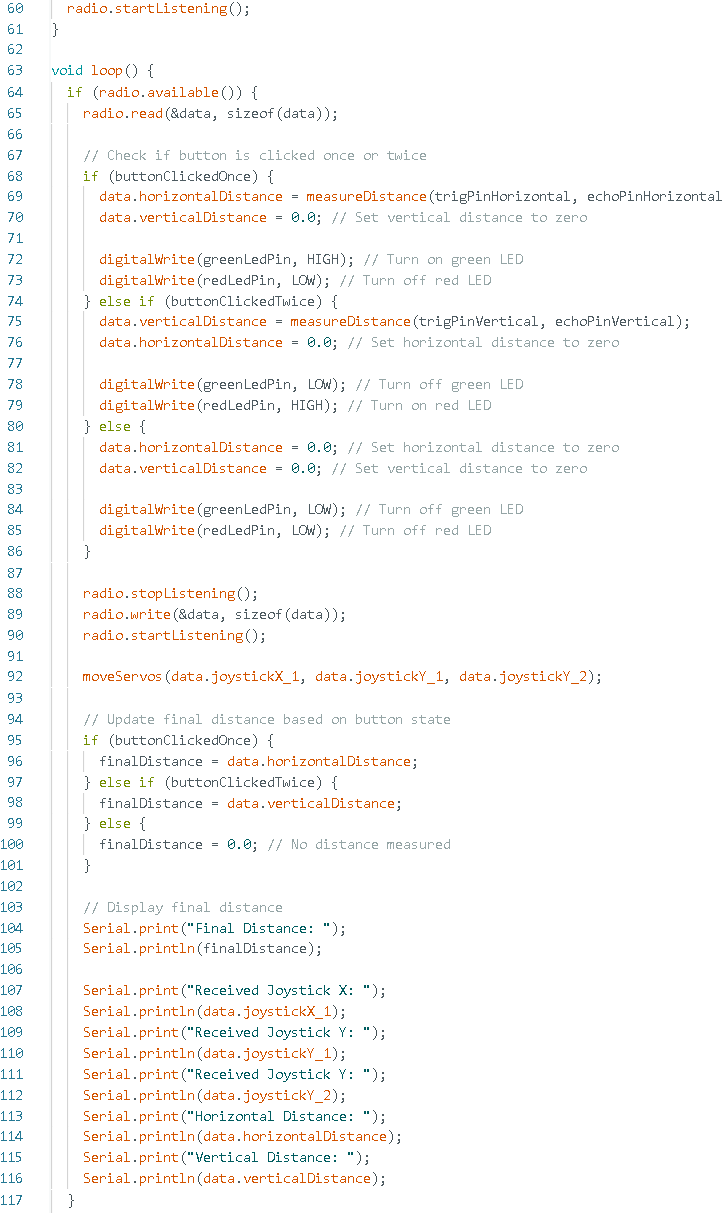
[picture p31: figure]

Annexure D: Control Centre code

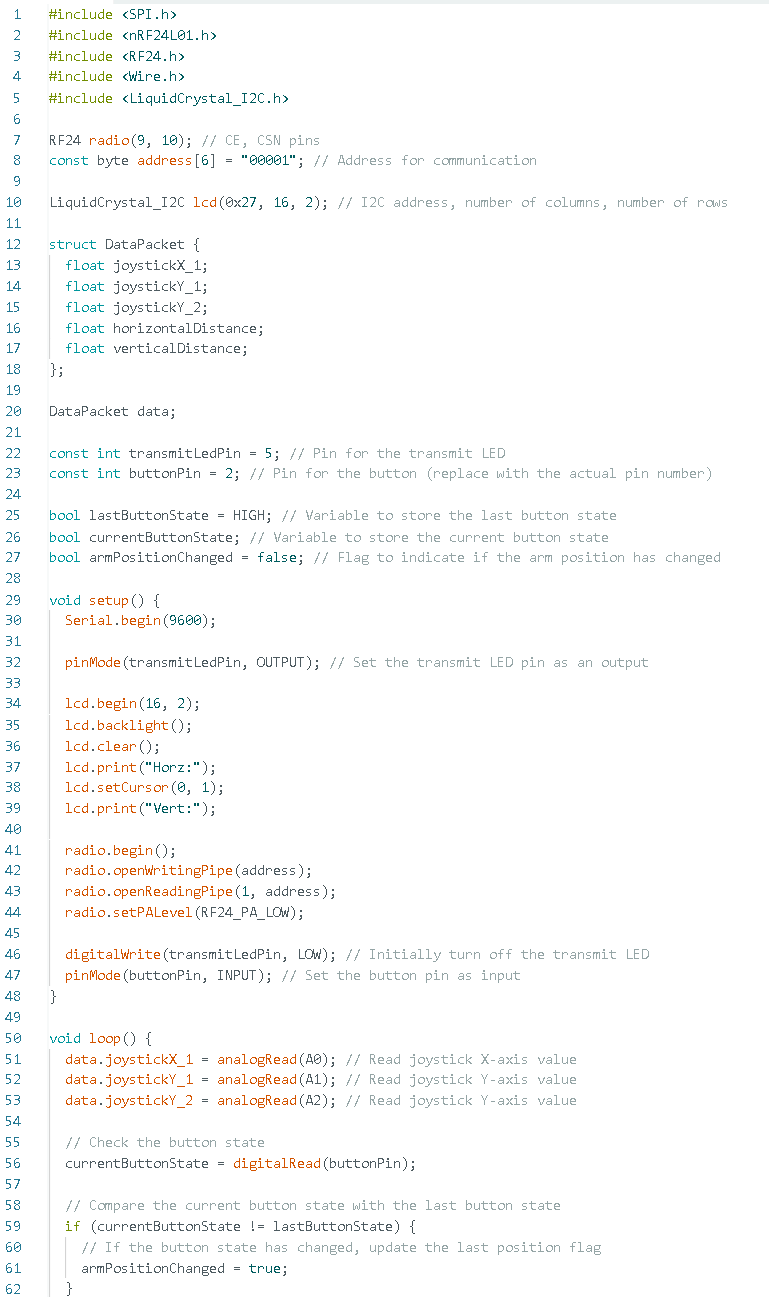
[picture p32: figure]

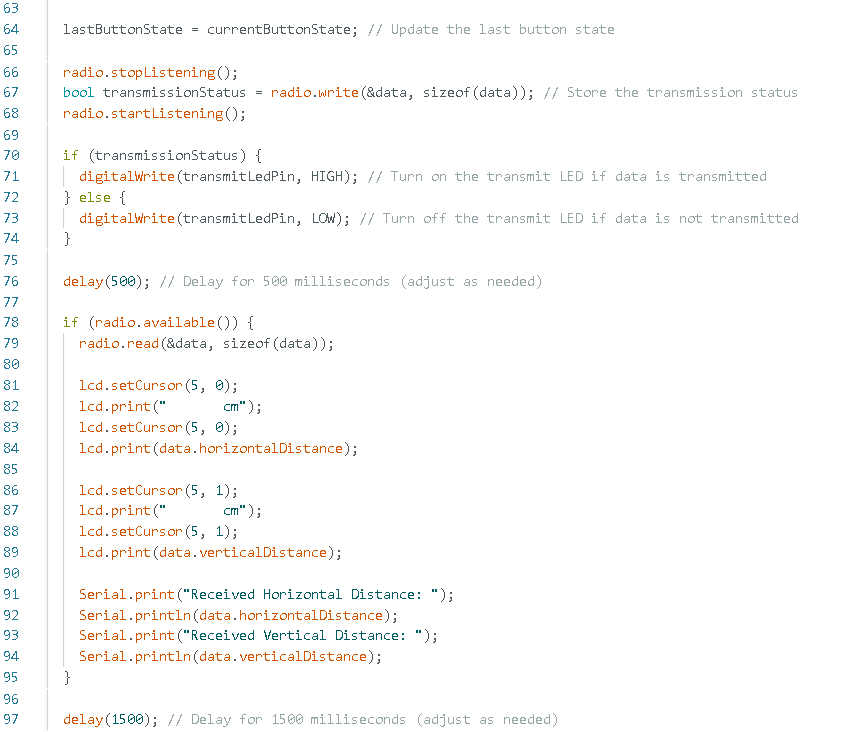
[picture p33: figure]

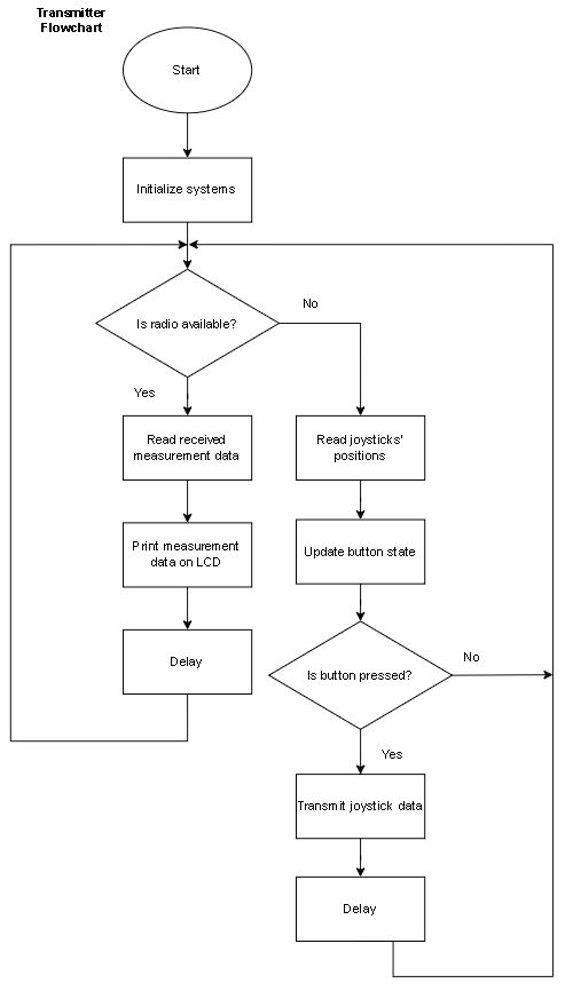
[picture p34: figure]

Annexure E: Control Centre flowchart

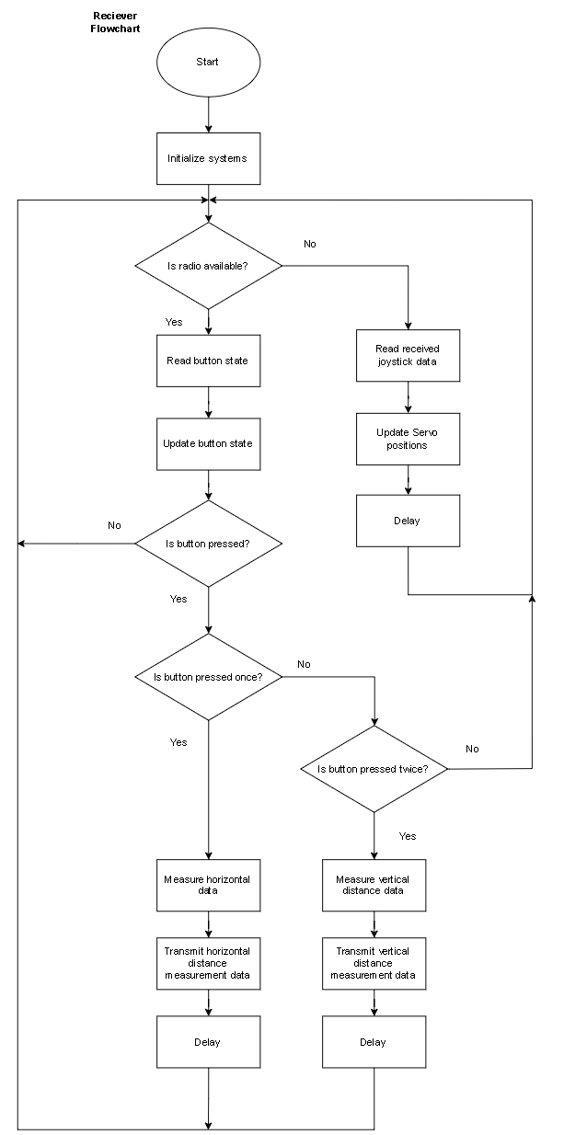
[picture p35: figure]

Annexure F: Robotic Arm flowchart

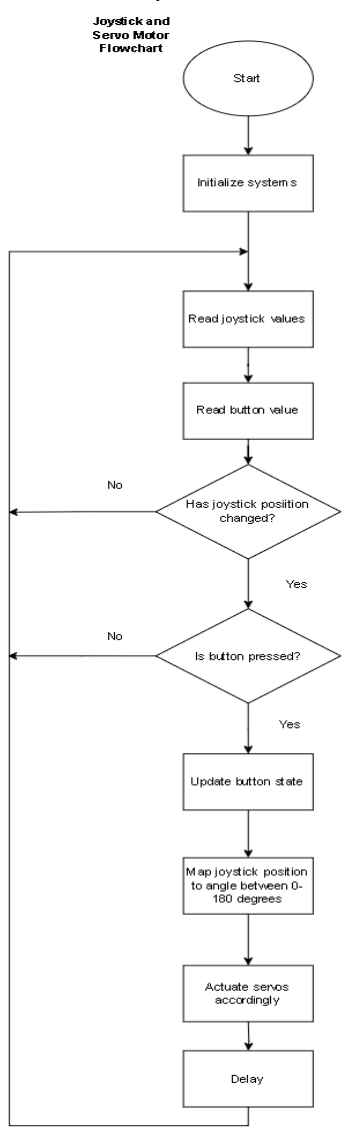
[picture p36: figure]

Annexure G: Joystick and servo motor subsystem flowchart

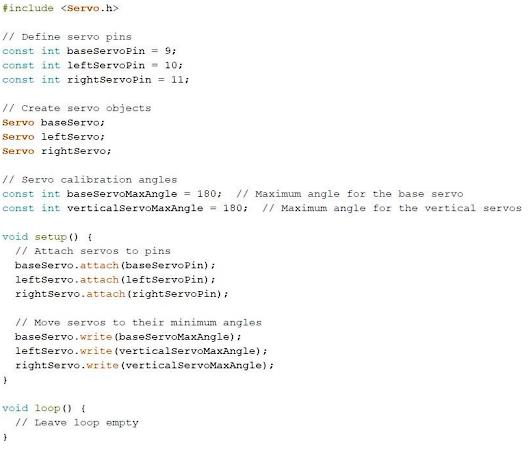
[picture p37: figure]

Annexure H: Maximum Angle Servo Motor Calibration

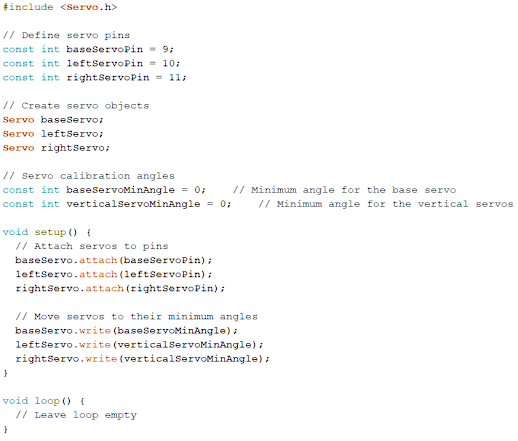
[picture p38: figure]

Annexure I: Minimum Angle Servo Motor Calibration

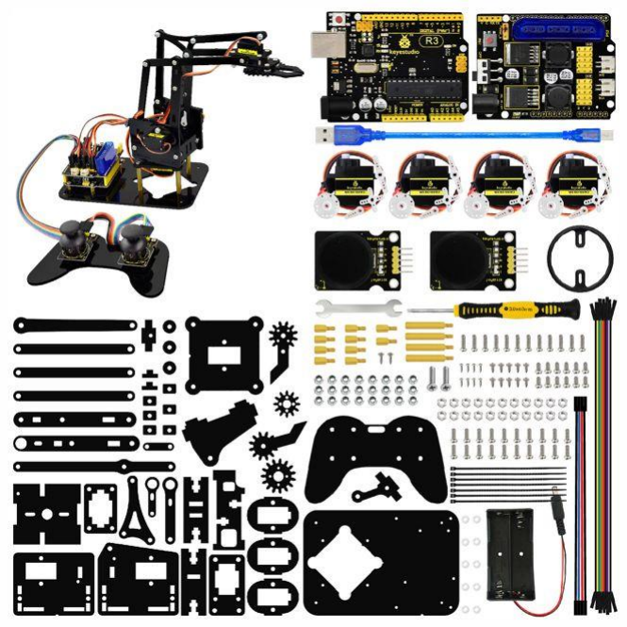
[picture p39: figure]

Annexure J: 4DOF Robotic Arm Kit

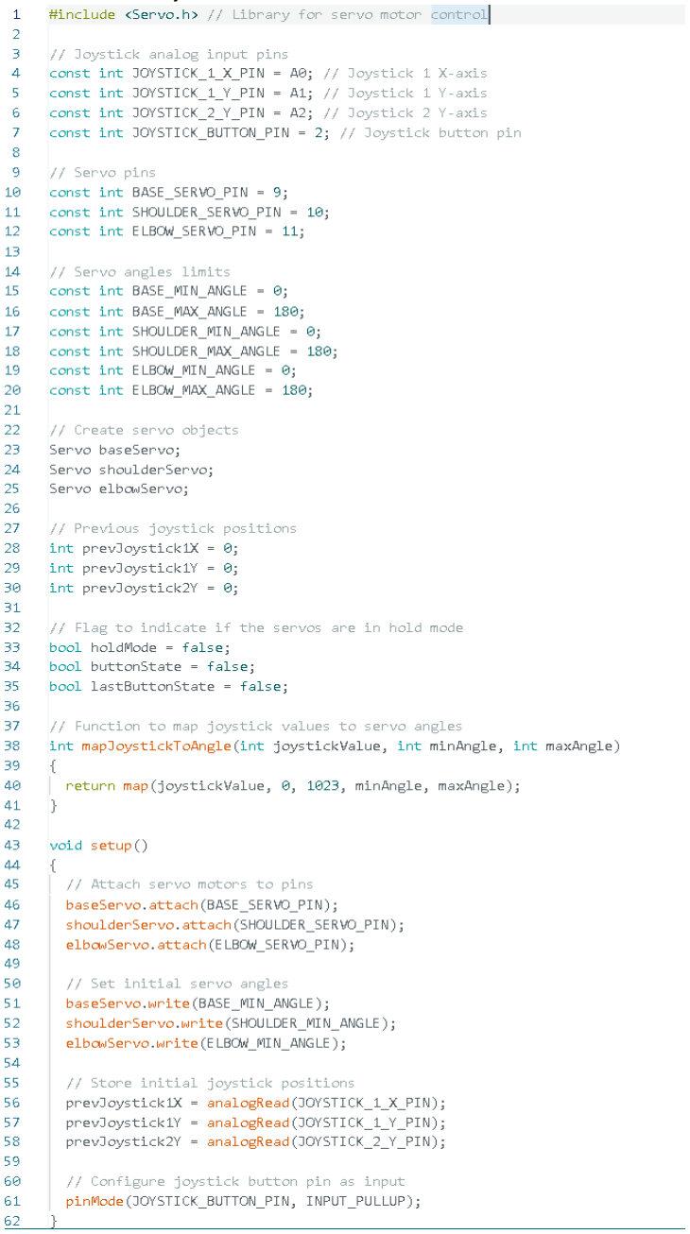
[picture p40: figure]

Annexure K: Subsystem Code

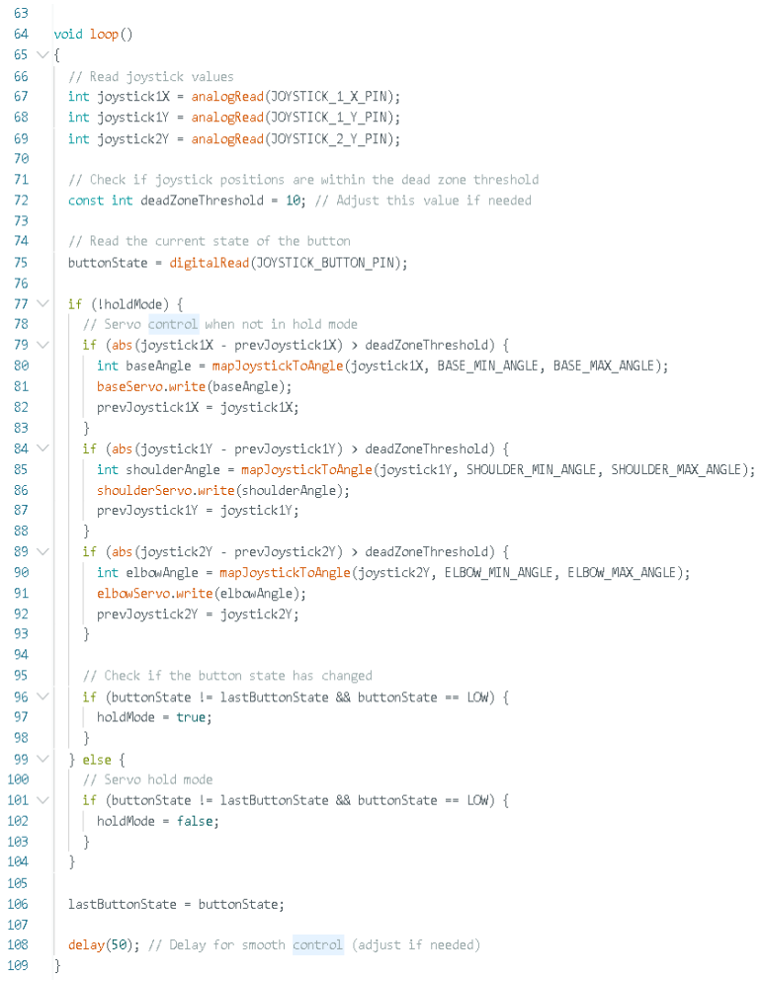
[picture p41: figure]
