GRiM-01/Robotic-Arm/Subsystems Schematics.png

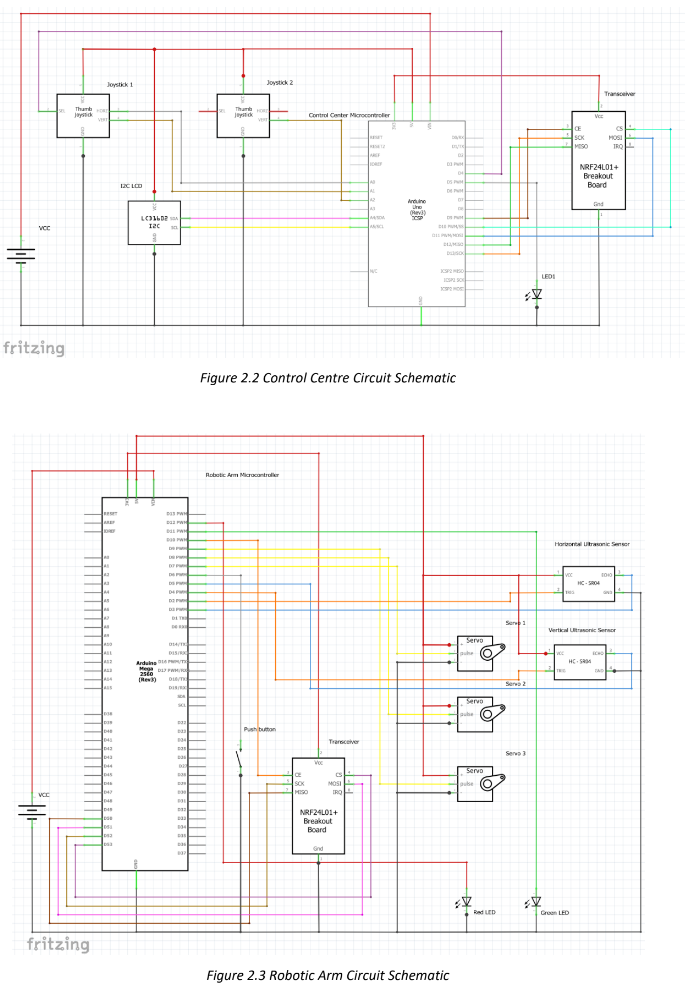
Subsystems Schematics.png
