GRiM-01/Robotic-Arm/Wiring Tables.png

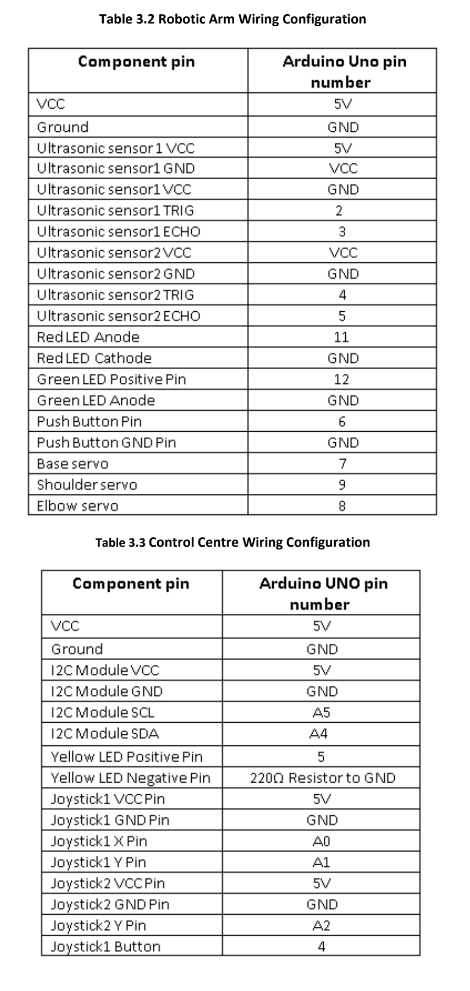
Wiring Tables.png
