GRiM-01/Robotic-Arm/(commit log)

2024-10-09 Rename image.png to Wiring Tables.png
2024-10-09 Rename image.png to Sub-Systems Schematics.png
